rizkyarfians/spff-iot-greenhouse/frontend/src/assets/login-greenhouse.png

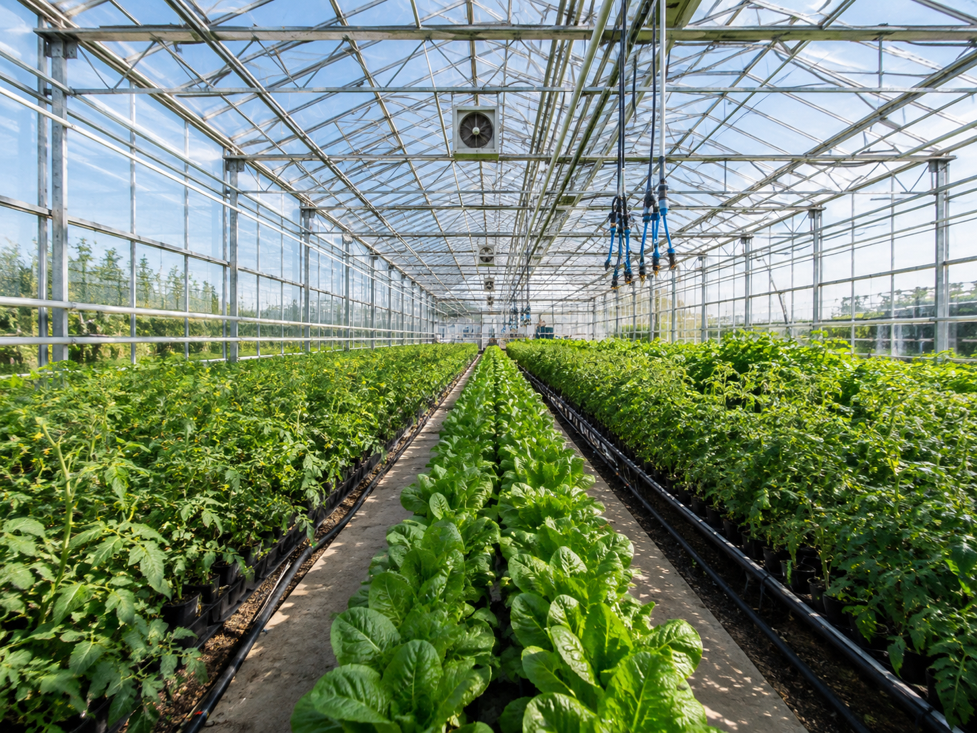
frontend/src/assets/login-greenhouse.png
