rizkyarfians/spff-iot-greenhouse/packages/contracts/README.md

# @spff/contracts

Package bersama untuk model dashboard serta protokol ESP32, edge gateway, MQTT worker, dan cloud API.

Perubahan yang tidak backward-compatible harus menaikkan `schemaVersion` dan mempertahankan handler versi lama selama proses migrasi device.
