rizkyarfians/spff-iot-greenhouse/firmware/SPFF_MASTER_ESP32S3_OTA_1.3.2_SENSOR_HEALTH/README.md

# SPFF 1.4.34 INDEPENDENT AI

Lihat docs/independent-soil-ec-ai.md di repository atau PANDUAN.md pada paket ZIP.
Seluruh file .h harus berada bersama sketch ini. Profil build ada di BUILD_PROFILE.json.
Binary paket adalah aplikasi saja, bukan merged full-flash. Upload melalui Arduino IDE
atau jalur OTA yang sudah mengetahui partisi aktif. Jangan menulis aplikasi ke 0x0.
Belum diuji pada hardware lapangan.
