rizkyarfians/spff-iot-greenhouse/docs/flowchart-datalog-local.png

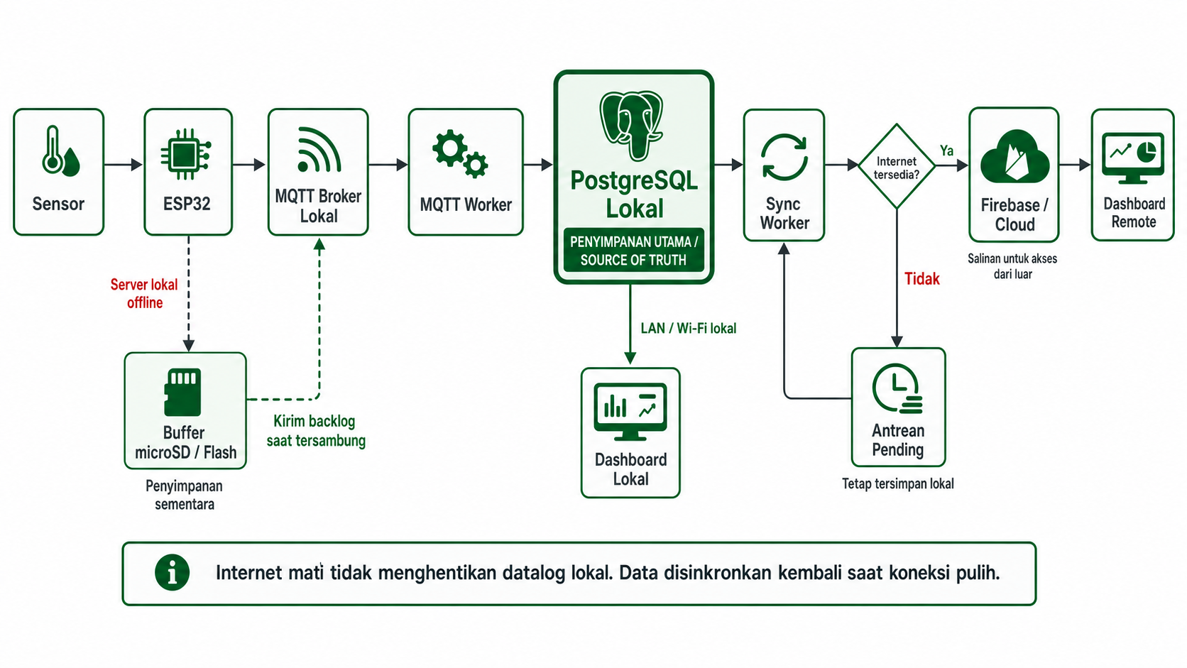
docs/flowchart-datalog-local.png
