rizkyarfians/spff-iot-greenhouse/docs/system-block-diagram-a4.jpg

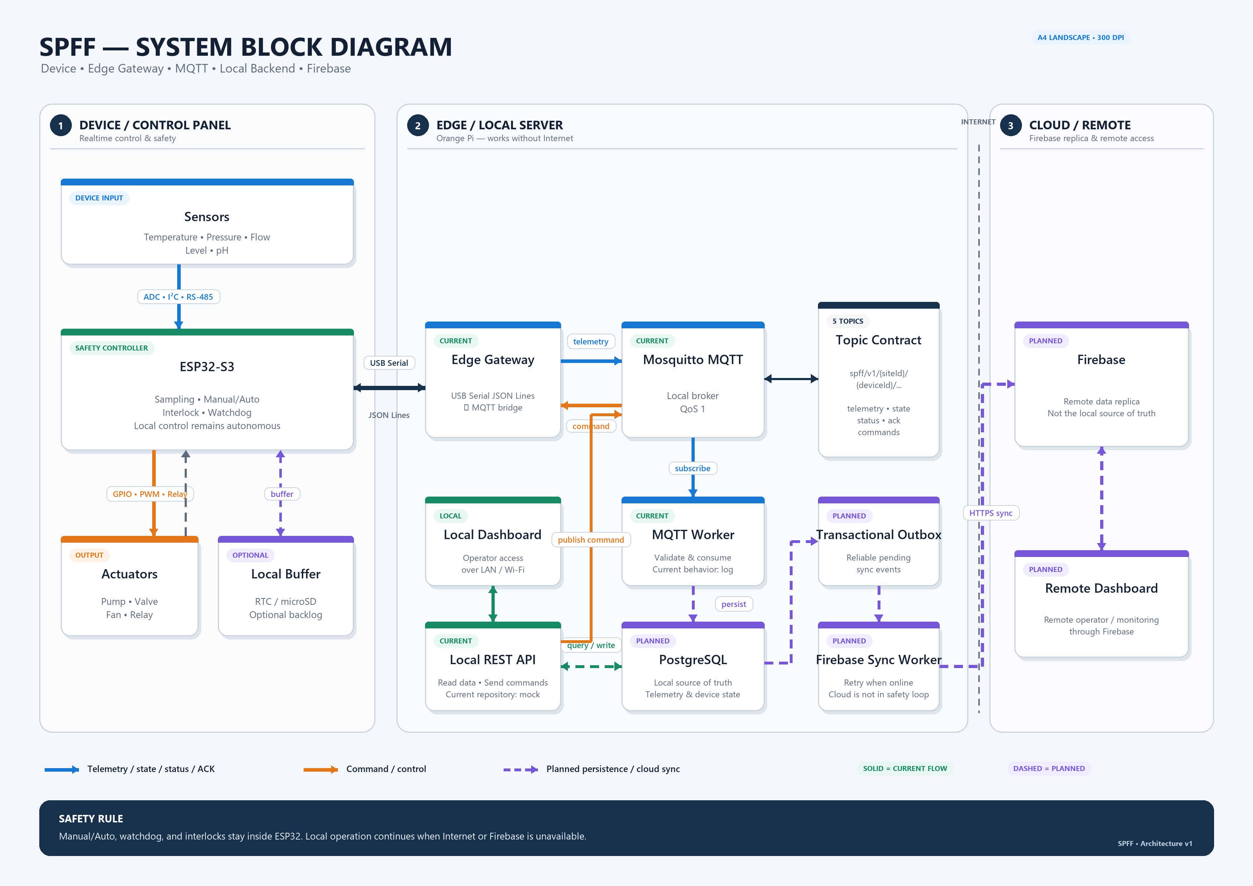
docs/system-block-diagram-a4.jpg
