rizkyarfians/spff-iot-greenhouse/firmware/SPFF_MASTER_1.4.10_SCHEDULE_SENSOR/SPFF_MASTER_1.4.10_SCHEDULE_SENSOR.ino

/*
  =============================================================================
  S2PFS MASTER SPFF FIRMWARE 1.4.7 RS485 PACING + ASYNC NETWORK + MANUAL MONITOR NAV + PZEM GPIO1/2
  Based on S2PFS Master V8.9.1 Edge Contract
  Waveshare ESP32-S3-ETH-8DI-8RO
  =============================================================================

  TUJUAN
  - Firmware master production dengan heartbeat dan Web OTA aman.
  - Menerima command set_pump JSON Lines dari Orange Pi dengan validation,
    expiry, dedup commandId, ACK accepted/completed/rejected, dan relay readback.
  - actuator_state hanya dikirim saat boot, actual state berubah, atau fault.
  - Mengirim device_status JSON Lines setelah init, setiap 30 detik, dan saat
    mode/sensor/system state berubah tanpa bergantung pada telemetry.
  - Telemetry snapshot dikirim tiap 30 detik dari last-valid per parameter (maks 300 detik / 5 menit).
  - Membaca:
      1) Nutrisense EC/pH       ID1 @ 9600, FC03
      2) SHT20 RS485            ID3 @ 9600, FC04
      3) ESP32 Slave PCB        ID5 @ 9600, FC03
      4) Soil 7-in-1 #1         ID1, adaptive sekitar 4800
      5) Soil 7-in-1 #2         ID2, adaptive sekitar 4800
      6) PZEM-004T v3           UART TTL dedicated GPIO1/2 @ 9600, FC04
  - W5500 Ethernet DHCP pada GPIO12..16; WiFi/AP tetap fallback untuk Web OTA.
  - NTP via Ethernet (prioritas) atau WiFi (fallback), lalu menulis RTC PCF85063.
  - LCD 20x4 + 4 tombol.
  - RTC onboard PCF85063/compatible @ I2C 0x51.
  - SHT20 terhubung langsung ke main RS485 A/B.
  - Sensor tetap dipoll terus; snapshot memakai last-good per field dengan batas umur 300 detik / 5 menit.
  - Fungsi THC15A diimplementasikan sebagai TIMER SOFTWARE di LCD.
  - Tidak ada sambungan fisik THC15A ke Master.
  - Full snapshot schedule_sync divalidasi, disimpan atomik ke NVS, dan dibalas
    schedule_sync_ack applied/rejected dengan revision dan storedScheduleCount.
  - automatic_control_sync disimpan ke NVS dan menjalankan hysteresis moisture
    serta closed-loop EC dosing dengan runtime/flow/volume/cooldown interlock.
  - Authority server: Orange Pi mengeksekusi jadwal melalui command set_pump.
  - Authority device: ESP32 mengeksekusi snapshot NVS untuk kedua pompa.
  - Timer mingguan lokal legacy tetap tersimpan tetapi tidak menulis relay.
  - Slave RS485 final memakai MAX485 MANUAL: RE+DE -> GPIO4.

  HARDWARE MASTER
  - RS485 onboard: RX GPIO18, TX GPIO17
  - PZEM TTL dedicated: ESP RX GPIO1 <- PZEM TX, ESP TX GPIO2 -> PZEM RX
  - W5500: INT12, MOSI13, MISO14, SCLK15, CS16
  - I2C: SDA GPIO42, SCL GPIO41
  - LCD: 0x27 atau 0x3F
  - RTC: 0x51
  - TCA9554 relay: 0x20
  - DI1 GPIO4  = CANCEL
  - DI2 GPIO5  = OK
  - DI3 GPIO6  = UP
  - DI4 GPIO7  = DOWN
  - Tombol INPUT_PULLUP, ACTIVE LOW

  SLAVE ID5 REGISTER
  HR0 = jarak tandon air cm x10
  HR1 = jarak tandon pupuk cm x10
  HR2 = flow air L/min x100
  HR3 = flow pupuk L/min x100
  HR4 = total air mL high word
  HR5 = total air mL low word
  HR6 = total pupuk mL high word
  HR7 = total pupuk mL low word

  LIBRARY EKSTERNAL MASTER
  - LiquidCrystal_I2C
  - Ethernet (Arduino Ethernet 2.x, W5500)
  Built-in:
  - Wire
  - Preferences
  - WiFi / WiFiUDP / WebServer / Update
  - SPI

  Serial protocol: 115200 JSON Lines
  =============================================================================
*/

#include <Arduino.h>
#include <Wire.h>
#include <LiquidCrystal_I2C.h>
#include <Preferences.h>
#include <WiFi.h>
#include <WiFiUdp.h>
#include <WebServer.h>
#include <Update.h>
#include <SPI.h>
#include <Ethernet.h>
#include <EthernetUdp.h>
#include <Dns.h>
#include <time.h>
#include <esp_system.h>
#include <math.h>
#include <stddef.h>
#include <string.h>

// Forward declarations untuk Arduino auto-prototype.
struct WeeklySchedule;
enum TimerMode : uint8_t;
enum ButtonId : uint8_t;
struct ButtonState;
struct PzemData;
struct SoilData;
struct CachedFloatValue;
struct CachedUIntValue;

// =============================================================================
// PRODUCTION SERIAL POLICY
// =============================================================================
// USB Serial dipakai eksklusif untuk SPFF JSON Lines. Human-readable debug,
// plotter, dan compact output dihapus dari build produksi agar tidak mencemari
// protokol Edge Gateway dan tidak menarik formatter/format string yang besar.

// ESP32 Arduino Core 2.0.x compatibility:
// - user-defined button types are declared before Arduino-generated prototypes
// - String(float, decimals) uses an explicit unsigned-int cast

// =============================================================================
// CONFIG
// =============================================================================
static constexpr uint8_t RS485_RX_PIN = 18;
static constexpr uint8_t RS485_TX_PIN = 17;

// PZEM-004T v3 dedicated TTL UART on GPIO44/GPIO43.
// USB CDC remains on native USB Serial, so UART pins 43/44 stay dedicated to PZEM.
// User has stabilized the interface voltage; keep the RX level within ESP32-S3 limits.
static constexpr uint8_t PZEM_RX_PIN = 44;  // ESP RX <- PZEM TX
static constexpr uint8_t PZEM_TX_PIN = 43;  // ESP TX -> PZEM RX
static constexpr uint32_t PZEM_BAUD = 9600UL;
static constexpr uint8_t PZEM_GENERAL_ADDRESS = 0xF8;
static constexpr uint8_t PZEM_DEFAULT_ADDRESS = 0x01;
static constexpr uint32_t PZEM_READ_INTERVAL_MS = 5000UL;
static constexpr uint32_t PZEM_HEALTH_MAX_AGE_MS = 60000UL;
static constexpr uint32_t PZEM_RESPONSE_TIMEOUT_MS = 350UL;

// Waveshare ESP32-S3-(POE)-ETH-8DI-8RO onboard W5500.
static constexpr uint8_t ETH_INT_PIN  = 12;
static constexpr uint8_t ETH_MOSI_PIN = 13;
static constexpr uint8_t ETH_MISO_PIN = 14;
static constexpr uint8_t ETH_SCLK_PIN = 15;
static constexpr uint8_t ETH_CS_PIN   = 16;
static constexpr uint32_t ETHERNET_MAINTAIN_INTERVAL_MS = 1000UL;

// NTP only disciplines the local RTC. System remains local-first when network is absent.
static constexpr char NTP_SERVER_PRIMARY[] = "pool.ntp.org";
static constexpr char NTP_SERVER_FALLBACK[] = "time.google.com";
static constexpr uint16_t NTP_LOCAL_PORT = 2390;
static constexpr uint32_t NTP_SYNC_INTERVAL_MS = 6UL * 60UL * 60UL * 1000UL;
static constexpr uint32_t NTP_RETRY_INTERVAL_MS = 5UL * 60UL * 1000UL;
static constexpr uint32_t NTP_INITIAL_DELAY_MS = 15000UL;
static constexpr uint32_t NTP_RESPONSE_TIMEOUT_MS = 1800UL;

// V1.4.6: Ethernet DHCP/DNS/NTP dipindahkan ke FreeRTOS background task.
// Operasi network yang bisa blocking tidak lagi berjalan di main control/UI loop.
// Bila internet/DHCP/NTP gagal, local control + sensor + USB gateway tetap berjalan.
static constexpr bool SPFF_ENABLE_ETHERNET_RUNTIME = true;
static constexpr bool SPFF_ENABLE_NTP_RUNTIME = true;
static constexpr uint32_t ETHERNET_RETRY_INTERVAL_MS = 60000UL;
static constexpr uint32_t NETWORK_TASK_INTERVAL_MS = 100UL;
static constexpr uint32_t NETWORK_TASK_STACK_BYTES = 7168UL;

static constexpr uint8_t I2C_SDA_PIN = 42;
static constexpr uint8_t I2C_SCL_PIN = 41;

static constexpr uint8_t BTN_CANCEL_PIN = 4;
static constexpr uint8_t BTN_OK_PIN     = 5;
static constexpr uint8_t BTN_UP_PIN     = 6;
static constexpr uint8_t BTN_DOWN_PIN   = 7;

// Waveshare ESP32-S3-ETH-8DI-8RO onboard buzzer.
// Board ini membutuhkan PWM/tone pada GPIO46.
// API di bawah kompatibel dengan ESP32 Arduino Core lama
// (ledcSetup + ledcAttachPin), sesuai core yang sedang dipakai.
static constexpr uint8_t BUZZER_PIN = 46;
static constexpr uint8_t BUZZER_CHANNEL = 0;
static constexpr uint32_t BUZZER_FREQ_HZ = 2700UL;
static constexpr uint8_t BUZZER_RESOLUTION_BITS = 8;

// Bunyi tombol pendek dan NON-BLOCKING agar UI tetap responsif.
static constexpr uint32_t BUTTON_BEEP_MS = 35UL;


static constexpr uint8_t NUTRI_ID = 1;
static constexpr uint8_t SHT20_ID = 3;
static constexpr uint8_t SOIL1_ID = 1;
static constexpr uint8_t SOIL2_ID = 2;
static constexpr uint8_t SLAVE_ID = 5;

static constexpr uint32_t BAUD_9600 = 9600UL;
static constexpr uint8_t SHT20_READ_ATTEMPTS = 3;
static constexpr uint32_t SHT20_RESPONSE_TIMEOUT_MS = 900UL;
static constexpr uint32_t SHT20_RETRY_GAP_MS = 160UL;
static constexpr uint8_t SHT20_FORCE_REOPEN_AFTER_ATTEMPT = 1;
static constexpr uint8_t SHT20_SPLIT_READ_ATTEMPTS = 2;
static constexpr uint32_t SHT20_PRE_REQUEST_QUIET_MS = 160UL;
static constexpr uint32_t SOIL_DEFAULT_BAUD = 4800UL;

// V8.4.1 SOIL FIX:
// Satu sensor Modbus mempunyai SATU baud, bukan baud berbeda per register.
// Kedua soil 7-in-1 dipoll sebagai satu blok FC03 R0..R6 @4800.
static constexpr uint32_t SOIL_FIXED_BAUD = 4850UL;
static constexpr uint32_t SOIL_SINGLE_TIMEOUT_MS = 260UL;

// FAST + ACCURATE rolling soil:
// tidak memaksa 7 register fresh pada cycle yang sama.
// Tiga register per sensor dicoba setiap cycle, hasil CRC-valid disimpan.
// Freshness internal Soil tetap 60 detik untuk health/priority polling.
// Telemetry snapshot boleh membawa last-valid field sampai 300 detik / 5 menit.
static constexpr uint8_t SOIL_REGS_PER_CYCLE = 3;
static constexpr uint8_t SOIL_ACQUIRE_RETRY = 5;
static constexpr uint8_t SOIL_MAINTENANCE_RETRY = 2;
static constexpr uint32_t SOIL_FIELD_MAX_AGE_MS = 60000UL;

static constexpr uint32_t SENSOR_CYCLE_INTERVAL_MS = 10000UL;
static constexpr uint32_t SHARED_RS485_POST_DEVICE_GAP_MS = 250UL;
static constexpr uint32_t LCD_REFRESH_MS = 250UL;


// Kalau satu polling Slave gagal tetapi data valid terakhir masih <=60 detik,
// data tetap boleh dipakai sebagai CACHE. Ini tidak memalsukan data baru;
// hanya menjaga tampilan/monitoring tidak jatuh ke STALE karena satu timeout.
static constexpr uint32_t SLAVE_CACHE_MAX_AGE_MS = 60000UL;

// V8.4.8:
// Sensor lambat tidak dinilai dari satu request saja.
// Fresh read tetap diutamakan, tetapi last-good singkat tetap dianggap sehat.
static constexpr uint32_t NUTRI_CACHE_MAX_AGE_MS = 60000UL;

// =============================================================================
// SOFTWARE CALIBRATION HOOKS - NUTRISENSE
// =============================================================================
// Default = identity, jadi TIDAK mengubah pembacaan sampai hasil kalibrasi
// terhadap larutan/alat referensi sudah tersedia.
// corrected = raw * GAIN + OFFSET
static constexpr float NUTRI_PH_GAIN = 1.0f;
static constexpr float NUTRI_PH_OFFSET = 0.0f;
static constexpr float NUTRI_EC_GAIN = 1.0f;
static constexpr float NUTRI_EC_OFFSET = 0.0f;
static constexpr float NUTRI_TEMP_GAIN = 1.0f;
static constexpr float NUTRI_TEMP_OFFSET = 0.0f;

// Status Soil ditentukan dari komunikasi sensor secara keseluruhan,
// bukan apakah semua 7 register berhasil refresh bersamaan.
// Jika tidak ada register valid selama 60 detik, sensor dianggap tidak current.
static constexpr uint32_t SOIL_SENSOR_MAX_SILENCE_MS = 60000UL;

static constexpr uint8_t TCA9554_ADDR = 0x20;
static constexpr uint8_t TCA_OUTPUT_REG = 0x01;
static constexpr uint8_t TCA_POLARITY_REG = 0x02;
static constexpr uint8_t TCA_CONFIG_REG = 0x03;

// FINAL ACTUATOR MAPPING - SESUAI WIRING FISIK PANEL
// CH1 = Pompa Nutrisi / Pupuk
// CH2 = Kosong
// CH3 = Pompa Penyiraman / Air
// CH4 = Kosong
// CH5..CH8 = Cadangan
//
// SHT20 terhubung LANGSUNG ke main RS485 A/B.
// Tidak ada relay isolasi SHT pada versi final ini.
static constexpr uint8_t RELAY_NUTRIENT = 1;    // CH1
static constexpr uint8_t RELAY_IRRIGATION = 3;  // CH3

static constexpr uint8_t PUMP_FERTILIZER_RELAY = RELAY_NUTRIENT;
static constexpr uint8_t PUMP_WATER_RELAY = RELAY_IRRIGATION;

static constexpr uint8_t RTC_ADDR = 0x51;

// PCF85063 register map:
// 0x00 Control_1
// 0x01 Control_2
// 0x02 Offset
// 0x03 RAM byte
// 0x04 Seconds
// 0x05 Minutes
// 0x06 Hours
// 0x07 Days
// 0x08 Weekdays
// 0x09 Months
// 0x0A Years
static constexpr uint8_t RTC_SECONDS_REG = 0x04;

static constexpr uint8_t SOIL_REG_COUNT = 7;

// =============================================================================
// GLOBAL
// =============================================================================
HardwareSerial RS485(1);
HardwareSerial PZEMSerial(2);
Preferences prefs;

EthernetUDP ntpEthernetUdp;
WiFiUDP ntpWifiUdp;

volatile bool ethernetInitialized = false;
volatile bool ethernetHasAddress = false;
uint32_t lastEthernetMaintainMs = 0;
uint32_t lastEthernetDhcpAttemptMs = 0;
uint32_t lastNtpAttemptMs = 0;
uint32_t lastNtpSuccessMs = 0;
volatile bool ntpEverSynced = false;

TaskHandle_t spffNetworkTaskHandle = nullptr;
portMUX_TYPE spffNetworkStateMux = portMUX_INITIALIZER_UNLOCKED;
volatile bool pendingNtpEpochReady = false;
uint32_t pendingNtpUtcEpoch = 0;

// Forward declaration: nilai SSID dipakai oleh LCD sebelum implementasi WiFi/OTA.
extern String fieldWifiSsid;

uint32_t activeBaud = 0;
uint32_t lastCycleStartMs = 0;


// =============================================================================
// SPFF EDGE GATEWAY - USB SERIAL JSON LINES
// =============================================================================
// Sesuai panduan integrasi:
// ESP32-S3 <-> USB Serial JSON Lines <-> Orange Pi Edge Gateway <-> MQTT
//
// Orange Pi:
//   Serial baud : 115200
//
// ESP32 TIDAK connect langsung ke MQTT.
static constexpr char SPFF_SITE_ID[] = "greenhouse-01";
static constexpr char SPFF_DEVICE_ID[] = "esp32-s3-01";
static constexpr char SPFF_FIRMWARE_VERSION[] = "1.4.10";

// Timer LCD/NVS legacy tidak boleh menjadi writer relay bersamaan dengan
// backend atau snapshot device. Data legacy tetap dipertahankan untuk rollback.
static constexpr bool SPFF_DISABLE_LEGACY_LOCAL_TIMER = true;

// Satu frame JSON termasuk terminator LF tidak boleh melebihi 16 KiB.
static constexpr size_t SPFF_SERIAL_FRAME_MAX = 16384;

// Arduino ESP32 Core 2.0.17 memakai RX queue USB CDC default 256 byte.
// Command set_pump sekitar 309 byte dan schedule_sync bisa mendekati 16 KiB,
// jadi queue harus dibesarkan sebelum Serial.begin() agar frame tidak terpotong.
static constexpr size_t SPFF_SERIAL_RX_QUEUE_BYTES = SPFF_SERIAL_FRAME_MAX;

// Heartbeat device hidup terpisah dari jadwal polling/pengiriman telemetry.
static constexpr uint32_t SPFF_STATUS_HEARTBEAT_INTERVAL_MS = 30000UL;
static constexpr uint32_t SPFF_STATUS_TIME_RETRY_INTERVAL_MS = 1000UL;
static constexpr uint32_t SPFF_SENSOR_VALID_MAX_SILENCE_MS = 300000UL;

// Telemetry snapshot dipublish setiap 30 detik. Sensor tetap dipoll terus
// mengikuti scheduler existing; publish tidak menunggu pembacaan dimulai.
static constexpr uint32_t SPFF_TELEMETRY_PUBLISH_INTERVAL_MS = 30000UL;

// Last-valid per parameter boleh dibawa ke snapshot berikutnya selama maksimal
// 300 detik / 5 menit. Setelah lewat batas ini field di-omit, bukan diisi nilai dummy.
// Cache ini hanya untuk TELEMETRY SNAPSHOT/dashboard. Safety, interlock, dan
// automatic control tetap memakai state pembacaan sensor current yang existing.
static constexpr uint32_t SPFF_TELEMETRY_SNAPSHOT_MAX_AGE_MS = 300000UL;
static constexpr uint8_t SPFF_SUPPORTED_TELEMETRY_FIELD_COUNT = 31;

// RTC Master saat ini dianggap waktu lokal WIB / UTC+7.
// recordedAt untuk gateway harus UTC ISO-8601 dengan akhiran Z.
static constexpr int16_t SPFF_LOCAL_UTC_OFFSET_MINUTES = 7 * 60;

// schedule_sync adalah full snapshot dan dapat mendekati batas Serial 16 KiB.
// Reserve awal tetap kecil; String tumbuh hanya ketika snapshot besar diterima.
static constexpr size_t SPFF_RX_LINE_MAX = SPFF_SERIAL_FRAME_MAX - 1U;
static constexpr size_t SPFF_RX_INITIAL_RESERVE = 2048U;
static constexpr uint8_t SPFF_JSON_MAX_DEPTH = 8;
static constexpr size_t SPFF_COMMAND_ID_MAX = 96;
static constexpr size_t SPFF_COMMAND_TARGET_MAX = 20;
static constexpr size_t SPFF_COMMAND_REASON_MAX = 32;
static constexpr uint8_t SPFF_COMMAND_HISTORY_SIZE = 16;
static constexpr uint32_t SPFF_ACTUATOR_STATE_POLL_INTERVAL_MS = 1000UL;

enum SpffSystemState : uint8_t {
  SPFF_SYSTEM_WAITING_TELEMETRY = 0,
  SPFF_SYSTEM_MONITORING = 1,
  SPFF_SYSTEM_DEGRADED = 2,
  SPFF_SYSTEM_SENSOR_FAULT = 3
};

String spffRxLine;
bool spffRxDroppingOversize = false;

char spffBootId[17] = {0};
uint32_t spffStatusCounter = 0;
uint32_t spffLastStatusSentMs = 0;
uint32_t spffLastStatusAttemptMs = 0;
uint32_t spffLastValidSensorMs = 0;
uint8_t spffObservedTimerMode = 0;
bool spffStatusEverSent = false;
bool spffStatusDirty = true;
bool spffStatusInitialized = false;
bool spffStatusModeInitialized = false;
bool spffLastStatusAttemptFailed = false;
bool spffSensorValid = false;
bool spffTelemetryEverValid = false;
SpffSystemState spffSystemState = SPFF_SYSTEM_WAITING_TELEMETRY;


struct SpffActuatorStateTracker {
  bool initialized = false;
  bool stateKnown = false;
  bool isActive = false;
};

struct SpffCommandHistoryEntry {
  bool used = false;
  char commandId[SPFF_COMMAND_ID_MAX + 1] = {0};
  char targetId[SPFF_COMMAND_TARGET_MAX + 1] = {0};
  char acknowledgedAt[25] = {0};
  char status[10] = {0};
  bool actualStateKnown = false;
  bool actualActive = false;
  char reason[SPFF_COMMAND_REASON_MAX + 1] = {0};
};

SpffActuatorStateTracker spffWaterStateTracker;
SpffActuatorStateTracker spffFertStateTracker;
SpffCommandHistoryEntry spffCommandHistory[SPFF_COMMAND_HISTORY_SIZE];
uint8_t spffCommandHistoryCursor = 0;
uint32_t spffActuatorStateCounter = 0;
uint32_t spffLastActuatorStatePollMs = 0;
String spffCurrentCommandIssuedAt;

static constexpr uint8_t SPFF_SYNCED_SCHEDULE_MAX = 64;
static constexpr uint32_t SPFF_SCHEDULE_STORE_MAGIC = 0x53504646UL;
static constexpr uint16_t SPFF_SCHEDULE_STORE_FORMAT = 1U;
static constexpr char SPFF_SCHEDULE_NVS_KEY[] = "srv_sched";

enum SpffScheduleAuthority : uint8_t {
  SPFF_SCHEDULE_AUTHORITY_SERVER = 0,
  SPFF_SCHEDULE_AUTHORITY_DEVICE = 1
};

enum SpffScheduleTarget : uint8_t {
  SPFF_SCHEDULE_TARGET_WATER = 1,
  SPFF_SCHEDULE_TARGET_FERT = 2
};

enum SpffScheduleRepeat : uint8_t {
  SPFF_SCHEDULE_REPEAT_DAILY = 1,
  SPFF_SCHEDULE_REPEAT_WEEKDAYS = 2,
  SPFF_SCHEDULE_REPEAT_WEEKENDS = 3,
  SPFF_SCHEDULE_REPEAT_ONCE = 4
};

struct SpffSyncedSchedule {
  uint32_t scheduleIdHash = 0;
  uint32_t onSecond = 0;
  uint32_t offSecond = 0;
  uint16_t runYear = 0;
  uint8_t runMonth = 0;
  uint8_t runDay = 0;
  uint8_t target = 0;
  uint8_t repeatRule = 0;
  uint8_t enabled = 0;
  uint8_t reserved = 0;
};

struct SpffSyncedScheduleStore {
  uint32_t magic = 0;
  uint16_t formatVersion = 0;
  uint8_t authority = SPFF_SCHEDULE_AUTHORITY_SERVER;
  uint8_t count = 0;
  uint32_t revision = 0;
  SpffSyncedSchedule schedules[SPFF_SYNCED_SCHEDULE_MAX];
  uint32_t checksum = 0;
};

SpffSyncedScheduleStore spffSyncedScheduleStore;
bool spffSyncedScheduleLoaded = false;

static constexpr uint32_t SPFF_AUTO_STORE_MAGIC = 0x4155544FUL;
static constexpr uint16_t SPFF_AUTO_STORE_FORMAT = 1U;
static constexpr char SPFF_AUTO_NVS_KEY[] = "auto_ctrl";
static constexpr char SPFF_AUTO_DAILY_NVS_KEY[] = "auto_daily";
static constexpr uint32_t SPFF_AUTO_DAILY_STORE_MAGIC = 0x4441494CUL;
static constexpr uint32_t SPFF_AUTO_EVAL_INTERVAL_MS = 500UL;
static constexpr uint32_t SPFF_AUTO_FLOW_GRACE_MS = 5000UL;

enum SpffOperatingMode : uint8_t {
  SPFF_MODE_MANUAL = 0,
  SPFF_MODE_AUTOMATIC = 1
};

enum SpffAutoFertState : uint8_t {
  SPFF_FERT_IDLE = 0,
  SPFF_FERT_DOSING = 1,
  SPFF_FERT_MIXING = 2
};

struct SpffWaterAutomaticConfig {
  uint8_t enabled = 0;
  uint8_t sensor = 1;
  uint8_t triggerSampleCount = 3;
  uint8_t reserved = 0;
  float moistureLowPercent = 0;
  float moistureTargetPercent = 0;
  float minFlowLpm = 0;
  uint32_t maxRuntimeSeconds = 0;
  uint32_t cooldownSeconds = 0;
  uint32_t sensorStaleSeconds = 120;
};

struct SpffFertilizerAutomaticConfig {
  uint8_t enabled = 0;
  uint8_t triggerSampleCount = 3;
  uint16_t reserved = 0;
  float ecLowUsCm = 0;
  float ecTargetUsCm = 0;
  float ecHighUsCm = 0;
  float maxDoseVolumeL = 0;
  float maxDailyVolumeL = 0;
  float minFlowLpm = 0;
  uint32_t dosePulseSeconds = 0;
  uint32_t mixingDelaySeconds = 0;
  uint32_t cooldownSeconds = 0;
  uint32_t sensorStaleSeconds = 120;
};

struct SpffAutomaticControlStore {
  uint32_t magic = 0;
  uint16_t formatVersion = 0;
  uint8_t desiredMode = SPFF_MODE_MANUAL;
  uint8_t reserved = 0;
  uint32_t revision = 0;
  SpffWaterAutomaticConfig water;
  SpffFertilizerAutomaticConfig fertilizer;
  uint32_t checksum = 0;
};

struct SpffAutomaticDailyStore {
  uint32_t magic = SPFF_AUTO_DAILY_STORE_MAGIC;
  uint16_t dateKey = 0;
  uint16_t reserved = 0;
  uint32_t fertilizerStartTotalMl = 0;
  uint32_t checksum = 0;
};

SpffAutomaticControlStore spffAutomaticControl;
bool spffAutomaticControlLoaded = false;
bool spffAutomaticPaused = false; // Dashboard OFF pauses auto until settings are explicitly saved again.
uint32_t spffLastAutoEvaluationMs = 0;
bool spffShutdownPending = false;
bool spffShutdownFaultLatched = false;

static void spffLoadShutdownFaultLatch() {
  const PreferenceType type = prefs.getType("pump_fault");

  if (type == PT_U8) {
    spffShutdownFaultLatched = prefs.getBool("pump_fault", true);
  } else if (type == PT_INVALID && !prefs.isKey("pump_fault")) {
    // Key belum tersedia: kondisi instalasi pertama.
    spffShutdownFaultLatched = false;
  } else {
    // Tipe data tidak sesuai: blokir ON.
    spffShutdownFaultLatched = true;
  }
}

static bool spffSaveShutdownFaultLatch() {
  return prefs.putBool(
    "pump_fault",
    spffShutdownFaultLatched
  ) == 1U;
}
uint32_t spffLastShutdownRetryMs = 0;
static constexpr uint32_t SPFF_SHUTDOWN_RETRY_INTERVAL_MS = 2000UL;
uint32_t spffWaterLastSampleMs = 0;
uint8_t spffWaterLowSampleCount = 0;
bool spffWaterAutoActive = false;
uint32_t spffWaterStartedMs = 0;
uint32_t spffWaterCooldownStartedMs = 0;
uint32_t spffFertLastSampleMs = 0;
uint8_t spffFertLowSampleCount = 0;
SpffAutoFertState spffFertState = SPFF_FERT_IDLE;
bool spffFertCycleLatched = false;
uint32_t spffFertStateStartedMs = 0;
uint32_t spffFertCooldownStartedMs = 0;
uint32_t spffFertPulseStartTotalMl = 0;
uint32_t spffFertCycleStartTotalMl = 0;
uint32_t spffFertDailyStartTotalMl = 0;
uint16_t spffFertDailyDateKey = 0;


LiquidCrystal_I2C lcd27(0x27, 20, 4);
LiquidCrystal_I2C lcd3F(0x3F, 20, 4);
LiquidCrystal_I2C *lcd = nullptr;
bool lcdReady = false;
// Redraw LCD dijadwalkan, bukan dilakukan langsung dari callback tombol.
// Ini mencegah I2C LCD masuk di tengah transaksi sensor/network dan menjaga UI responsif.
bool lcdDirty = true;

bool relayReady = false;
uint8_t relayState = 0;

bool rtcReady = false;

// =============================================================================
// DATA TYPES
// =============================================================================
struct RTCDateTime {
  uint8_t second = 0;
  uint8_t minute = 0;
  uint8_t hour = 0;
  uint8_t day = 1;
  uint8_t weekday = 0;
  uint8_t month = 1;
  uint8_t year = 0; // 00..99 = 2000..2099
  bool valid = false;
  bool oscillatorStopped = false;
};

RTCDateTime rtcNow;

struct NutriData {
  float ph = NAN;
  float ec = NAN;
  float temp = NAN;
  bool hasValue = false;
  bool fresh = false;
  uint32_t lastGoodMs = 0;
};

struct SHTData {
  float temp = NAN;
  float rh = NAN;
  bool hasValue = false;
  bool fresh = false;
  uint32_t lastGoodMs = 0;
};

struct PzemData {
  float voltageV = NAN;
  float currentA = NAN;
  float powerW = NAN;
  float energyKwh = NAN;
  float frequencyHz = NAN;
  float powerFactor = NAN;
  bool hasValue = false;
  bool fresh = false;
  uint32_t lastGoodMs = 0;
  uint32_t lastAttemptMs = 0;
  uint8_t respondingAddress = 0;
};

struct SoilData {
  uint16_t raw[SOIL_REG_COUNT] = {0,0,0,0,0,0,0};
  bool has[SOIL_REG_COUNT] = {false,false,false,false,false,false,false};
  bool freshField[SOIL_REG_COUNT] = {false,false,false,false,false,false,false};
  uint32_t regBaud[SOIL_REG_COUNT] = {
    SOIL_DEFAULT_BAUD, SOIL_DEFAULT_BAUD, SOIL_DEFAULT_BAUD,
    SOIL_DEFAULT_BAUD, SOIL_DEFAULT_BAUD, SOIL_DEFAULT_BAUD,
    SOIL_DEFAULT_BAUD
  };
  uint32_t fallbackBaud = SOIL_DEFAULT_BAUD;
  bool complete = false;
  bool fresh = false;
  uint32_t lastGoodMs = 0;
};

struct SlaveData {
  float waterDistanceCm = NAN;
  float fertDistanceCm = NAN;
  float waterFlowLpm = NAN;
  float fertFlowLpm = NAN;
  uint32_t waterTotalMl = 0;
  uint32_t fertTotalMl = 0;
  bool waterDistanceValid = false;
  bool fertDistanceValid = false;
  bool totalsAvailable = false;
  bool hasValue = false;
  bool fresh = false;
  uint32_t lastGoodMs = 0;
};

// =============================================================================
// TELEMETRY SNAPSHOT CACHE
// =============================================================================
// Cache ini menyimpan last-valid PER PARAMETER beserta waktu pembacaan aslinya.
// Timestamp cache TIDAK diperbarui jika sensor gagal dibaca, sehingga nilai lama
// tidak pernah dibuat terlihat lebih fresh dari kondisi sebenarnya.
struct CachedFloatValue {
  float value = NAN;
  uint32_t updatedMs = 0;
  bool hasValue = false;
};

struct CachedUIntValue {
  uint32_t value = 0;
  uint32_t updatedMs = 0;
  bool hasValue = false;
};

struct TelemetrySnapshotCache {
  CachedFloatValue liquidPh;
  CachedFloatValue liquidEcUsCm;
  CachedFloatValue liquidTemp;
  CachedFloatValue airTemp;
  CachedFloatValue airHumidity;

  CachedFloatValue acVoltageV;
  CachedFloatValue acCurrentA;
  CachedFloatValue acPowerW;
  CachedFloatValue acEnergyKwh;
  CachedFloatValue acFrequencyHz;
  CachedFloatValue acPowerFactor;

  CachedFloatValue soil1Moisture;
  CachedFloatValue soil1Temp;
  CachedUIntValue soil1EcUsCm;
  CachedFloatValue soil1Ph;
  CachedUIntValue soil1N;
  CachedUIntValue soil1P;
  CachedUIntValue soil1K;

  CachedFloatValue soil2Moisture;
  CachedFloatValue soil2Temp;
  CachedUIntValue soil2EcUsCm;
  CachedFloatValue soil2Ph;
  CachedUIntValue soil2N;
  CachedUIntValue soil2P;
  CachedUIntValue soil2K;

  CachedFloatValue tankWaterDistanceCm;
  CachedFloatValue tankFertDistanceCm;
  CachedFloatValue flowWaterLpm;
  CachedFloatValue flowFertLpm;
  CachedFloatValue flowWaterTotalL;
  CachedFloatValue flowFertTotalL;
};


// =============================================================================
// WEEKLY TIMER SOFTWARE - PENGGANTI THC15A
// =============================================================================
// Fitur:
// - 16 program mingguan.
// - Jam aktif dan jam nonaktif masing-masing sampai presisi menit.
// - Mode OTOMATIS / PAKSA AKTIF / PAKSA NONAKTIF.
// - Atur jam & tanggal RTC dari LCD.
// - Hapus satu program / hapus semua program.
// - Semua pengaturan timer disimpan ke NVS.
//
// CATATAN KESELAMATAN:
// Output timer MENGENDALIKAN relay penyiraman CH3 (PUMP_WATER_RELAY).
// CH1 pompa nutrisi TIDAK pernah ikut timer penyiraman.
// Saat timer tidak aktif, CH3 dipaksa OFF. Saat timer aktif, CH3 dipaksa ON.

struct WeeklySchedule {
  bool enabled = false;
  uint8_t daysMask = 0x3F;   // Senin-Sabtu
  uint16_t startMinute = 360; // 06:00
  uint16_t endMinute = 390;   // 06:30
};

static constexpr uint8_t WEEKLY_SCHEDULE_COUNT = 16;

// Hari memakai bit:
// bit0 Senin, bit1 Selasa, bit2 Rabu, bit3 Kamis,
// bit4 Jumat, bit5 Sabtu, bit6 Minggu.
struct DayPreset {
  const char *name;
  uint8_t mask;
};

const DayPreset DAY_PRESETS[] = {
  {"Setiap Hari", 0x7F},
  {"Senin-Jumat", 0x1F},
  {"Senin-Sabtu", 0x3F},
  {"Senin", 0x01},
  {"Selasa", 0x02},
  {"Rabu", 0x04},
  {"Kamis", 0x08},
  {"Jumat", 0x10},
  {"Sabtu", 0x20},
  {"Minggu", 0x40}
};

static constexpr uint8_t DAY_PRESET_COUNT =
  sizeof(DAY_PRESETS) / sizeof(DAY_PRESETS[0]);

enum TimerMode : uint8_t {
  TIMER_MODE_AUTO = 0,
  TIMER_MODE_FORCE_ON = 1,
  TIMER_MODE_FORCE_OFF = 2
};

WeeklySchedule weeklySchedules[WEEKLY_SCHEDULE_COUNT];
WeeklySchedule editSchedule;

TimerMode timerMode = TIMER_MODE_AUTO;
TimerMode editTimerMode = TIMER_MODE_AUTO;

uint8_t scheduleMenuIndex = 0;
uint8_t scheduleEditIndex = 0;
uint8_t scheduleEditField = 0;
bool scheduleValueEditing = false;

RTCDateTime editRtc;
uint8_t rtcEditField = 0;
bool rtcValueEditing = false;

uint8_t clearProgramIndex = 0;
bool clearProgramConfirm = false;
bool clearAllConfirm = false;


// IMPORTANT:
// Button types are intentionally declared before the first function.
// Arduino IDE auto-generates function prototypes; keeping these types here
// prevents "ButtonState does not name a type" on ESP32 Arduino Core 2.0.x.
enum ButtonId : uint8_t {
  BUTTON_CANCEL,
  BUTTON_OK,
  BUTTON_UP,
  BUTTON_DOWN
};

struct ButtonState {
  uint8_t pin;
  bool stablePressed;
  bool lastRawPressed;
  uint32_t rawChangedMs;

  // Untuk fungsi tahan tombol (auto-repeat).
  uint32_t pressedSinceMs;
  uint32_t lastRepeatMs;

  explicit ButtonState(uint8_t buttonPin)
    : pin(buttonPin),
      stablePressed(false),
      lastRawPressed(false),
      rawChangedMs(0),
      pressedSinceMs(0),
      lastRepeatMs(0) {
  }
};

NutriData nutri;
SHTData sht;
PzemData pzem;
SoilData soil1;
SoilData soil2;
SlaveData slaveData;
bool slaveCycleOk = false;
bool nutriCycleOk = false;
bool shtCycleOk = false;

TelemetrySnapshotCache telemetrySnapshot;
uint32_t spffLastTelemetrySentMs = 0;

uint32_t soil1RegLastGoodMs[SOIL_REG_COUNT] = {0};
uint32_t soil2RegLastGoodMs[SOIL_REG_COUNT] = {0};

uint8_t soil1AcquireCursor = 0;
uint8_t soil2AcquireCursor = 0;

// =============================================================================
// FORWARD DECLARATIONS
// =============================================================================
// Explicit declarations ini penting untuk Arduino ESP32 Core 2.0.17.
// Tanpa ini, Arduino preprocessor kadang membuat prototype sebelum struct
// RTCDateTime / SoilData / WeeklySchedule / ButtonState dideklarasikan.

void appSetup();
void appLoop();

void initEthernet();
void serviceEthernet();
bool ethernetUsable();
void serviceNetworkTime();
bool syncRtcFromNtp();
void startSpffNetworkTask();
void spffNetworkTask(void *parameter);
void clearPzemSerial();
bool readPzem();
void servicePzem();
bool pzemHealthValid();
uint16_t modbusCRC(const uint8_t *data, size_t len);

void serviceSpffGatewaySerial();
void initializeSpffDeviceStatus();
String buildDeviceStatusPayload();
bool sendDeviceStatus();
bool shouldSendStatusHeartbeat();
void serviceDeviceStatus();
void updateSystemState(bool anySensorValid, bool allSensorsValid);
void captureTelemetrySnapshot();
bool telemetrySnapshotHasAnyValidData();
uint8_t telemetrySnapshotValidFieldCount();
uint8_t telemetrySnapshotHealthyFieldCount();
void spffAppendTelemetrySensorHealth(String &json);
bool shouldPublishTelemetrySnapshot();
void serviceTelemetrySnapshot();
void sendTelemetryIfValid();
const char* spffModeText();
const char* spffSystemStateText();
bool spffWriteJsonLine(const String &json);
bool sendSpffTelemetry();
bool sendSpffActuatorStateEvent(
  const char *targetId,
  bool stateKnown,
  bool actualActive,
  const String &commandId,
  const char *reason
);
void serviceSpffActuatorStateChanges(bool forcePoll = false);
void processSpffCommandLine(const String &line);
void processSpffScheduleSyncLine(
  const String &line,
  size_t rootStart,
  size_t rootEnd
);
void processSpffAutomaticControlSyncLine(
  const String &line,
  size_t rootStart,
  size_t rootEnd
);
void loadSpffSyncedSchedules();
void serviceSpffSyncedScheduleOutput();
void loadSpffAutomaticControl();
void loadSpffAutomaticDailyState();
void serviceSpffAutomaticControl();
bool sendSpffActuatorAckAt(
  const String &commandId,
  const String &targetId,
  const char *acknowledgedAt,
  const char *status,
  bool actualStateKnown,
  bool actualActive,
  const char *reason
);
bool sendSpffActuatorAck(
  const String &commandId,
  const String &targetId,
  const char *status,
  bool actualStateKnown,
  bool actualActive,
  const char *reason,
  String *acknowledgedAtOut = nullptr
);
String spffUtcIso8601();
uint32_t spffUtcEpoch();

bool rtcRead(RTCDateTime &dt);
bool rtcWrite(const RTCDateTime &dt);
RTCDateTime compileDateTime();
bool rtcDateLooksSane(const RTCDateTime &dt);

bool scheduleDayEnabled(
  const WeeklySchedule &schedule,
  uint8_t weekdayIndex
);

bool buttonRawPressed(
  const ButtonState &b
);

void handleButton(
  ButtonId id
);

void serviceOneButton(
  ButtonState &b,
  ButtonId id
);

uint8_t countFreshSoil(
  const SoilData &soil
);

uint8_t countSoilHave(
  const SoilData &soil
);

bool allSoilHaveData(
  const SoilData &soil
);

String staleSoilRegs(
  const SoilData &soil
);

void refreshSoilFreshFlags(
  uint8_t number,
  SoilData &soil
);

bool registerAlreadyChosen(
  uint8_t reg,
  const uint8_t chosen[SOIL_REGS_PER_CYCLE],
  uint8_t chosenCount
);

bool chooseMissingRegister(
  uint8_t number,
  const SoilData &soil,
  const uint8_t chosen[SOIL_REGS_PER_CYCLE],
  uint8_t chosenCount,
  uint8_t &regOut
);

bool chooseOldestRegister(
  uint8_t number,
  const SoilData &soil,
  const uint8_t chosen[SOIL_REGS_PER_CYCLE],
  uint8_t chosenCount,
  uint8_t &selected
);

uint8_t buildSoilTargetList(
  uint8_t number,
  const SoilData &soil,
  uint8_t target[SOIL_REGS_PER_CYCLE]
);

bool readSoil(
  uint8_t number,
  uint8_t sensorId,
  SoilData &soil
);

String soilStateText(
  const SoilData &soil
);

void renderSoilDetail(
  uint8_t number,
  const SoilData &soil
);

void loadSoilNVS(
  uint8_t number,
  SoilData &soil
);

void serviceButtons();
void renderUI();

void initBuzzer();
void serviceBuzzer();
void beepButton();
void serviceLCDRefresh();
void uiDelay(uint32_t ms);
String rtcTimeText(bool withSeconds = true);
String rtcDateText();

WeeklySchedule defaultScheduleFor(uint8_t index);
void loadWeeklyTimerNVS();
void saveScheduleNVS(uint8_t index);
void saveTimerModeNVS();
void clearProgram(uint8_t index);
void clearAllPrograms();

bool weeklyScheduleActive(uint8_t index);
int8_t activeScheduleIndex();
bool timerOutputActive();
void serviceIrrigationTimerOutput();

const char* timerModeText(TimerMode mode);

void openScheduleEditor(uint8_t index);
void changeScheduleValue(int delta);
void commitScheduleEditor();

void openRtcEditor();
void changeRtcValue(int delta);
bool saveRtcEditor();

uint8_t daysInMonth(uint8_t month, uint8_t year2);

// =============================================================================
// UTILITY
// =============================================================================
bool i2cExists(uint8_t address) {
  Wire.beginTransmission(address);
  return Wire.endTransmission() == 0;
}

uint8_t bcdToDec(uint8_t value) {
  return ((value >> 4) * 10U) + (value & 0x0F);
}

uint8_t decToBcd(uint8_t value) {
  return ((value / 10U) << 4) | (value % 10U);
}

String pad2(uint8_t value) {
  if (value < 10) return "0" + String(value);
  return String(value);
}

// =============================================================================
// RTC PCF85063 @ 0x51
// =============================================================================
bool rtcRead(RTCDateTime &dt) {
  if (!rtcReady) return false;

  Wire.beginTransmission(RTC_ADDR);
  Wire.write(RTC_SECONDS_REG);

  if (Wire.endTransmission(false) != 0) {
    return false;
  }

  uint8_t requested = Wire.requestFrom((int)RTC_ADDR, 7);
  if (requested != 7) return false;

  uint8_t secRaw = Wire.read();
  uint8_t minRaw = Wire.read();
  uint8_t hourRaw = Wire.read();
  uint8_t dayRaw = Wire.read();
  uint8_t weekRaw = Wire.read();
  uint8_t monthRaw = Wire.read();
  uint8_t yearRaw = Wire.read();

  dt.oscillatorStopped = (secRaw & 0x80) != 0;
  dt.second = bcdToDec(secRaw & 0x7F);
  dt.minute = bcdToDec(minRaw & 0x7F);
  dt.hour = bcdToDec(hourRaw & 0x3F);
  dt.day = bcdToDec(dayRaw & 0x3F);
  dt.weekday = weekRaw & 0x07;
  dt.month = bcdToDec(monthRaw & 0x1F);
  dt.year = bcdToDec(yearRaw);

  dt.valid =
    dt.second < 60 &&
    dt.minute < 60 &&
    dt.hour < 24 &&
    dt.day >= 1 && dt.day <= 31 &&
    dt.month >= 1 && dt.month <= 12 &&
    dt.year <= 99;

  return dt.valid;
}

bool rtcWrite(const RTCDateTime &dt) {
  if (!rtcReady) return false;

  Wire.beginTransmission(RTC_ADDR);
  Wire.write(RTC_SECONDS_REG);
  Wire.write(decToBcd(dt.second) & 0x7F);
  Wire.write(decToBcd(dt.minute) & 0x7F);
  Wire.write(decToBcd(dt.hour) & 0x3F);
  Wire.write(decToBcd(dt.day) & 0x3F);
  Wire.write(dt.weekday & 0x07);
  Wire.write(decToBcd(dt.month) & 0x1F);
  Wire.write(decToBcd(dt.year));

  return Wire.endTransmission() == 0;
}

uint8_t compileMonth(const char *month3) {
  static const char *months[] = {
    "Jan","Feb","Mar","Apr","May","Jun",
    "Jul","Aug","Sep","Oct","Nov","Dec"
  };

  for (uint8_t i = 0; i < 12; i++) {
    if (strncmp(month3, months[i], 3) == 0) return i + 1;
  }

  return 1;
}

RTCDateTime compileDateTime() {
  RTCDateTime dt;

  char month[4] = {__DATE__[0], __DATE__[1], __DATE__[2], '\0'};
  dt.month = compileMonth(month);

  dt.day =
    (__DATE__[4] == ' ' ? 0 : (__DATE__[4] - '0') * 10) +
    (__DATE__[5] - '0');

  int fullYear =
    (__DATE__[7] - '0') * 1000 +
    (__DATE__[8] - '0') * 100 +
    (__DATE__[9] - '0') * 10 +
    (__DATE__[10] - '0');

  dt.year = (uint8_t)(fullYear % 100);

  dt.hour = (__TIME__[0] - '0') * 10 + (__TIME__[1] - '0');
  dt.minute = (__TIME__[3] - '0') * 10 + (__TIME__[4] - '0');
  dt.second = (__TIME__[6] - '0') * 10 + (__TIME__[7] - '0');
  dt.weekday = 0;
  dt.valid = true;
  dt.oscillatorStopped = false;

  return dt;
}

bool rtcDateLooksSane(const RTCDateTime &dt) {
  // Project deployed in 2026; values such as year 00 normally mean the RTC
  // has never been initialized. Keep a broad lower bound so the RTC remains
  // battery-backed after a normal reboot.
  return
    dt.valid &&
    dt.year >= 24 &&
    dt.year <= 99;
}

void initRTC() {
  rtcReady = i2cExists(RTC_ADDR);

  if (!rtcReady) {
    return;
  }

  RTCDateTime dt;

  bool readOk = rtcRead(dt);

  if (
    !readOk ||
    dt.oscillatorStopped ||
    !rtcDateLooksSane(dt)
  ) {
    RTCDateTime compiled = compileDateTime();

    if (rtcWrite(compiled)) {
      rtcNow = compiled;
    } else {
    }
  } else {
    rtcNow = dt;
  }

}

void updateRTC() {
  RTCDateTime dt;
  if (rtcRead(dt)) rtcNow = dt;
}

String rtcTimeText(bool withSeconds) {
  if (!rtcReady || !rtcNow.valid) return "--:--:--";

  String value = pad2(rtcNow.hour) + ":" + pad2(rtcNow.minute);
  if (withSeconds) value += ":" + pad2(rtcNow.second);
  return value;
}

String rtcDateText() {
  if (!rtcReady || !rtcNow.valid) return "--/--/--";
  return pad2(rtcNow.day) + "/" + pad2(rtcNow.month) + "/" + pad2(rtcNow.year);
}


// =============================================================================
// W5500 ETHERNET + ASYNC NTP -> RTC
// =============================================================================
// IMPORTANT:
// - Semua operasi DHCP/DNS/NTP yang dapat blocking dijalankan di background task.
// - Main loop hanya membaca status cache dan menerapkan epoch NTP ke RTC.
// - I2C RTC tetap ditulis dari main loop agar tidak race dengan LCD/RTC sensor logic.

static bool ethernetUsableRaw() {
  if (!SPFF_ENABLE_ETHERNET_RUNTIME) {
    return false;
  }

  if (Ethernet.hardwareStatus() == EthernetNoHardware) {
    return false;
  }

  if (Ethernet.linkStatus() == LinkOFF) {
    return false;
  }

  const IPAddress ip = Ethernet.localIP();
  return ip[0] != 0 || ip[1] != 0 || ip[2] != 0 || ip[3] != 0;
}

bool ethernetUsable() {
  return
    SPFF_ENABLE_ETHERNET_RUNTIME &&
    ethernetInitialized &&
    ethernetHasAddress;
}

void buildEthernetMac(uint8_t mac[6]) {
  const uint64_t efuseMac = ESP.getEfuseMac();

  // Locally administered unicast MAC derived deterministically from ESP eFuse.
  mac[0] = 0x02;
  mac[1] = (uint8_t)(efuseMac >> 32);
  mac[2] = (uint8_t)(efuseMac >> 24);
  mac[3] = (uint8_t)(efuseMac >> 16);
  mac[4] = (uint8_t)(efuseMac >> 8);
  mac[5] = (uint8_t)(efuseMac);
}

void initEthernet() {
  if (!SPFF_ENABLE_ETHERNET_RUNTIME) {
    ethernetInitialized = false;
    ethernetHasAddress = false;
    return;
  }

  lastEthernetDhcpAttemptMs = millis();

  pinMode(ETH_CS_PIN, OUTPUT);
  digitalWrite(ETH_CS_PIN, HIGH);
  pinMode(ETH_INT_PIN, INPUT_PULLUP);

  SPI.begin(
    ETH_SCLK_PIN,
    ETH_MISO_PIN,
    ETH_MOSI_PIN,
    ETH_CS_PIN
  );

  Ethernet.init(ETH_CS_PIN);

  uint8_t mac[6];
  buildEthernetMac(mac);

  // Bisa blocking beberapa detik, tetapi fungsi ini hanya dipanggil dari
  // background task sehingga tidak menahan tombol/LCD/control loop.
  const int dhcpOk = Ethernet.begin(
    mac,
    5000UL,
    1500UL
  );

  ethernetInitialized =
    Ethernet.hardwareStatus() != EthernetNoHardware;

  ethernetHasAddress =
    dhcpOk != 0 &&
    ethernetUsableRaw();

  lastEthernetMaintainMs = millis();
}

void serviceEthernet() {
  if (!SPFF_ENABLE_ETHERNET_RUNTIME) {
    return;
  }

  const uint32_t now = millis();

  if (!ethernetInitialized) {
    if (
      lastEthernetDhcpAttemptMs == 0 ||
      (uint32_t)(now - lastEthernetDhcpAttemptMs) >=
        ETHERNET_RETRY_INTERVAL_MS
    ) {
      initEthernet();
    }
    return;
  }

  // Jika W5500 ada tetapi DHCP/link belum usable, lakukan bounded DHCP retry.
  if (!ethernetHasAddress) {
    if (
      lastEthernetDhcpAttemptMs == 0 ||
      (uint32_t)(now - lastEthernetDhcpAttemptMs) >=
        ETHERNET_RETRY_INTERVAL_MS
    ) {
      initEthernet();
    }
    return;
  }

  if (
    (uint32_t)(now - lastEthernetMaintainMs) <
    ETHERNET_MAINTAIN_INTERVAL_MS
  ) {
    return;
  }

  lastEthernetMaintainMs = now;

  // DHCP renew/rebind juga hanya berjalan di background network task.
  (void)Ethernet.maintain();
  ethernetHasAddress = ethernetUsableRaw();
}

static void buildNtpPacket(uint8_t packet[48]) {
  memset(packet, 0, 48);
  packet[0] = 0b11100011; // LI=3, Version=4, Mode=3 client
  packet[1] = 0;
  packet[2] = 6;
  packet[3] = 0xEC;
  packet[12] = 49;
  packet[13] = 0x4E;
  packet[14] = 49;
  packet[15] = 52;
}

template <typename UdpType>
bool ntpQuery(
  UdpType &udp,
  const IPAddress &serverIp,
  uint32_t &unixEpochOut
) {
  uint8_t packet[48];
  buildNtpPacket(packet);

  udp.stop();

  if (!udp.begin(NTP_LOCAL_PORT)) {
    return false;
  }

  if (!udp.beginPacket(serverIp, 123)) {
    udp.stop();
    return false;
  }

  udp.write(packet, sizeof(packet));

  if (!udp.endPacket()) {
    udp.stop();
    return false;
  }

  const uint32_t started = millis();

  while (
    (uint32_t)(millis() - started) <
    NTP_RESPONSE_TIMEOUT_MS
  ) {
    const int packetSize = udp.parsePacket();

    if (packetSize >= 48) {
      uint8_t response[48];
      const int readLen = udp.read(response, sizeof(response));
      udp.stop();

      if (readLen < 48) {
        return false;
      }

      const uint32_t ntpSeconds =
        ((uint32_t)response[40] << 24) |
        ((uint32_t)response[41] << 16) |
        ((uint32_t)response[42] << 8) |
        (uint32_t)response[43];

      static constexpr uint32_t NTP_UNIX_EPOCH_DELTA = 2208988800UL;

      if (ntpSeconds <= NTP_UNIX_EPOCH_DELTA) {
        return false;
      }

      unixEpochOut =
        ntpSeconds -
        NTP_UNIX_EPOCH_DELTA;

      return true;
    }

    // Jangan memanggil UI/I2C/command handler dari task network.
    // Yield hanya task ini; main loop tetap berjalan normal di core aplikasi.
    vTaskDelay(pdMS_TO_TICKS(2));
  }

  udp.stop();
  return false;
}

bool writeRtcFromUtcEpoch(uint32_t utcEpoch) {
  if (!rtcReady || utcEpoch == 0) {
    return false;
  }

  // RTC intentionally stored as Asia/Jakarta local time (UTC+7)
  // to preserve existing local schedule/UI behavior.
  const time_t localEpoch =
    (time_t)utcEpoch +
    (time_t)SPFF_LOCAL_UTC_OFFSET_MINUTES * 60;

  struct tm localTm;
  memset(&localTm, 0, sizeof(localTm));

  if (gmtime_r(&localEpoch, &localTm) == nullptr) {
    return false;
  }

  const int fullYear = localTm.tm_year + 1900;

  if (
    fullYear < 2024 ||
    fullYear > 2099
  ) {
    return false;
  }

  RTCDateTime dt;
  dt.second = (uint8_t)localTm.tm_sec;
  dt.minute = (uint8_t)localTm.tm_min;
  dt.hour = (uint8_t)localTm.tm_hour;
  dt.day = (uint8_t)localTm.tm_mday;

  // tm_wday: Sunday=0. RTC/UI convention: Monday=0 ... Sunday=6.
  dt.weekday =
    localTm.tm_wday == 0
      ? 6
      : (uint8_t)(localTm.tm_wday - 1);

  dt.month = (uint8_t)(localTm.tm_mon + 1);
  dt.year = (uint8_t)(fullYear - 2000);
  dt.valid = true;
  dt.oscillatorStopped = false;

  if (!rtcWrite(dt)) {
    return false;
  }

  rtcNow = dt;
  return true;
}

bool resolveNtpServer(
  const char *host,
  IPAddress &serverIp,
  bool useEthernet
) {
  // DNS bisa blocking; aman karena fungsi hanya dipanggil network task.
  if (useEthernet) {
    const IPAddress dnsServer = Ethernet.dnsServerIP();

    if (dnsServer == IPAddress(0, 0, 0, 0)) {
      return false;
    }

    DNSClient dns;
    dns.begin(dnsServer);
    return dns.getHostByName(host, serverIp) == 1;
  }

  return WiFi.hostByName(host, serverIp) == 1;
}

static void queueNtpEpoch(uint32_t utcEpoch) {
  portENTER_CRITICAL(&spffNetworkStateMux);
  pendingNtpUtcEpoch = utcEpoch;
  pendingNtpEpochReady = true;
  portEXIT_CRITICAL(&spffNetworkStateMux);
}

bool syncRtcFromNtp() {
  const bool useEthernet =
    ethernetUsable();

  const bool useWifi =
    WiFi.status() == WL_CONNECTED;

  if (!useEthernet && !useWifi) {
    return false;
  }

  const char *servers[] = {
    NTP_SERVER_PRIMARY,
    NTP_SERVER_FALLBACK
  };

  for (uint8_t i = 0; i < 2; i++) {
    IPAddress serverIp;

    if (
      !resolveNtpServer(
        servers[i],
        serverIp,
        useEthernet
      )
    ) {
      continue;
    }

    uint32_t utcEpoch = 0;
    const bool queried =
      useEthernet
        ? ntpQuery(
            ntpEthernetUdp,
            serverIp,
            utcEpoch
          )
        : ntpQuery(
            ntpWifiUdp,
            serverIp,
            utcEpoch
          );

    if (queried && utcEpoch != 0) {
      // Jangan menulis RTC/I2C dari network task.
      queueNtpEpoch(utcEpoch);
      return true;
    }
  }

  return false;
}

static void serviceNetworkTimeFromTask() {
  if (!SPFF_ENABLE_NTP_RUNTIME) {
    return;
  }

  const uint32_t now = millis();

  if (
    !ntpEverSynced &&
    lastNtpAttemptMs == 0 &&
    now < NTP_INITIAL_DELAY_MS
  ) {
    return;
  }

  const uint32_t interval =
    ntpEverSynced
      ? NTP_SYNC_INTERVAL_MS
      : NTP_RETRY_INTERVAL_MS;

  if (
    lastNtpAttemptMs != 0 &&
    (uint32_t)(now - lastNtpAttemptMs) <
      interval
  ) {
    return;
  }

  if (
    !ethernetUsable() &&
    WiFi.status() != WL_CONNECTED
  ) {
    return;
  }

  lastNtpAttemptMs = now;
  (void)syncRtcFromNtp();
}

void serviceNetworkTime() {
  // Main-loop side only: consume an NTP epoch obtained by background task
  // and write PCF85063 over I2C safely from the application task.
  uint32_t utcEpoch = 0;
  bool hasPending = false;

  portENTER_CRITICAL(&spffNetworkStateMux);
  if (pendingNtpEpochReady) {
    utcEpoch = pendingNtpUtcEpoch;
    pendingNtpEpochReady = false;
    hasPending = true;
  }
  portEXIT_CRITICAL(&spffNetworkStateMux);

  if (!hasPending) {
    return;
  }

  if (writeRtcFromUtcEpoch(utcEpoch)) {
    ntpEverSynced = true;
    lastNtpSuccessMs = millis();
    lcdDirty = true;
  }
}

void spffNetworkTask(void *parameter) {
  (void)parameter;

  // Delay kecil agar boot/UI/USB serial siap terlebih dahulu.
  vTaskDelay(pdMS_TO_TICKS(3000));

  if (SPFF_ENABLE_ETHERNET_RUNTIME) {
    initEthernet();
  }

  for (;;) {
    serviceEthernet();
    serviceNetworkTimeFromTask();
    vTaskDelay(pdMS_TO_TICKS(NETWORK_TASK_INTERVAL_MS));
  }
}

void startSpffNetworkTask() {
  if (
    !SPFF_ENABLE_ETHERNET_RUNTIME &&
    !SPFF_ENABLE_NTP_RUNTIME
  ) {
    return;
  }

  if (spffNetworkTaskHandle != nullptr) {
    return;
  }

  const BaseType_t result = xTaskCreatePinnedToCore(
    spffNetworkTask,
    "spff-network",
    NETWORK_TASK_STACK_BYTES,
    nullptr,
    1,
    &spffNetworkTaskHandle,
    0
  );

  if (result != pdPASS) {
    spffNetworkTaskHandle = nullptr;
    ethernetInitialized = false;
    ethernetHasAddress = false;
  }
}


// =============================================================================
// WEEKLY TIMER LOGIC
// =============================================================================
uint8_t weekdayMondayZero(
  uint8_t year2,
  uint8_t month,
  uint8_t day
) {
  // Sakamoto: 0=Sunday .. 6=Saturday.
  static const uint8_t t[] = {
    0, 3, 2, 5, 0, 3,
    5, 1, 4, 6, 2, 4
  };

  int year =
    2000 +
    year2;

  if (month < 3) {
    year -= 1;
  }

  uint8_t sundayZero =
    (uint8_t)(
      (
        year +
        year / 4 -
        year / 100 +
        year / 400 +
        t[month - 1] +
        day
      ) %
      7
    );

  // Monday=0 .. Sunday=6.
  return
    sundayZero == 0
    ? 6
    : sundayZero - 1;
}

uint8_t previousWeekday(
  uint8_t dayIndex
) {
  return
    dayIndex == 0
    ? 6
    : dayIndex - 1;
}

uint16_t buildMinute(
  uint8_t hour,
  uint8_t minute
) {
  return
    (uint16_t)(
      (hour % 24U) *
      60U +
      (minute % 60U)
    );
}

uint8_t scheduleHour(
  uint16_t minuteOfDay
) {
  return
    (minuteOfDay % 1440U) /
    60U;
}

uint8_t scheduleMinutePart(
  uint16_t minuteOfDay
) {
  return
    (minuteOfDay % 1440U) %
    60U;
}

uint8_t findDayPreset(
  uint8_t mask
) {
  for (
    uint8_t i = 0;
    i < DAY_PRESET_COUNT;
    i++
  ) {
    if (
      DAY_PRESETS[i].mask ==
      mask
    ) {
      return i;
    }
  }

  return 0;
}

bool scheduleDayEnabled(
  const WeeklySchedule &schedule,
  uint8_t weekdayIndex
) {
  if (
    weekdayIndex >
    6
  ) {
    return false;
  }

  return
    (
      schedule.daysMask &
      (uint8_t)(
        1U <<
        weekdayIndex
      )
    ) !=
    0;
}

WeeklySchedule defaultScheduleFor(
  uint8_t index
) {
  WeeklySchedule defaults;

  defaults.enabled =
    false;

  defaults.daysMask =
    0x3F;

  // Waktu default berurutan supaya 16 program mudah dibedakan.
  // Semua tetap NONAKTIF sampai operator mengaktifkannya.
  defaults.startMinute =
    (uint16_t)(
      (
        360U +
        (uint16_t)index *
        30U
      ) %
      1440U
    );

  defaults.endMinute =
    (uint16_t)(
      (
        defaults.startMinute +
        30U
      ) %
      1440U
    );

  return defaults;
}

bool weeklyScheduleActive(
  uint8_t index
) {
  if (
    index >=
      WEEKLY_SCHEDULE_COUNT ||
    !rtcReady ||
    !rtcNow.valid
  ) {
    return false;
  }

  const WeeklySchedule &schedule =
    weeklySchedules[index];

  if (
    !schedule.enabled
  ) {
    return false;
  }

  uint8_t today =
    weekdayMondayZero(
      rtcNow.year,
      rtcNow.month,
      rtcNow.day
    );

  uint16_t nowMinute =
    (uint16_t)rtcNow.hour *
    60U +
    rtcNow.minute;

  uint16_t start =
    schedule.startMinute %
    1440U;

  uint16_t finish =
    schedule.endMinute %
    1440U;

  // Jam aktif == jam nonaktif dianggap program kosong.
  if (
    start ==
    finish
  ) {
    return false;
  }

  // Jadwal dalam hari yang sama.
  if (
    start <
    finish
  ) {
    return
      scheduleDayEnabled(
        schedule,
        today
      ) &&
      nowMinute >=
        start &&
      nowMinute <
        finish;
  }

  // Jadwal melewati tengah malam.
  // Contoh Senin 23:00 -> Selasa 01:00.
  if (
    nowMinute >=
    start
  ) {
    return
      scheduleDayEnabled(
        schedule,
        today
      );
  }

  return
    nowMinute <
      finish &&
    scheduleDayEnabled(
      schedule,
      previousWeekday(
        today
      )
    );
}

int8_t activeScheduleIndex() {
  for (
    uint8_t i = 0;
    i < WEEKLY_SCHEDULE_COUNT;
    i++
  ) {
    if (
      weeklyScheduleActive(
        i
      )
    ) {
      return
        (int8_t)i;
    }
  }

  return -1;
}

const char* timerModeText(
  TimerMode mode
) {
  if (SPFF_DISABLE_LEGACY_LOCAL_TIMER) {
    return "BACKEND";
  }

  switch (mode) {
    case TIMER_MODE_FORCE_ON:
      return "PAKSA AKTIF";

    case TIMER_MODE_FORCE_OFF:
      return "PAKSA NONAKTIF";

    case TIMER_MODE_AUTO:
    default:
      return "OTOMATIS";
  }
}

bool timerOutputActive() {
  switch (timerMode) {
    case TIMER_MODE_FORCE_ON:
      return true;

    case TIMER_MODE_FORCE_OFF:
      return false;

    case TIMER_MODE_AUTO:
    default:
      return
        activeScheduleIndex() >=
        0;
  }
}

// Nama lama dipertahankan supaya integrasi berikutnya tidak perlu dirombak.
void loadWeeklyTimerNVS() {
  for (
    uint8_t i = 0;
    i < WEEKLY_SCHEDULE_COUNT;
    i++
  ) {
    WeeklySchedule defaults =
      defaultScheduleFor(i);

    String prefix =
      "j" +
      String(i + 1);

    weeklySchedules[i].enabled =
      prefs.getBool(
        (prefix + "en").c_str(),
        defaults.enabled
      );

    weeklySchedules[i].daysMask =
      prefs.getUChar(
        (prefix + "day").c_str(),
        defaults.daysMask
      );

    weeklySchedules[i].startMinute =
      prefs.getUShort(
        (prefix + "start").c_str(),
        defaults.startMinute
      );

    weeklySchedules[i].endMinute =
      prefs.getUShort(
        (prefix + "end").c_str(),
        defaults.endMinute
      );

    if (
      weeklySchedules[i].daysMask ==
        0 ||
      weeklySchedules[i].daysMask >
        0x7F
    ) {
      weeklySchedules[i].daysMask =
        defaults.daysMask;
    }

    weeklySchedules[i].startMinute %=
      1440U;

    weeklySchedules[i].endMinute %=
      1440U;
  }

  uint8_t storedMode =
    prefs.getUChar(
      "timer_mode",
      (uint8_t)TIMER_MODE_AUTO
    );

  if (
    storedMode >
    (uint8_t)TIMER_MODE_FORCE_OFF
  ) {
    storedMode =
      (uint8_t)TIMER_MODE_AUTO;
  }

  timerMode =
    (TimerMode)storedMode;

  editTimerMode =
    timerMode;
}

void saveScheduleNVS(
  uint8_t index
) {
  if (
    index >=
    WEEKLY_SCHEDULE_COUNT
  ) {
    return;
  }

  String prefix =
    "j" +
    String(index + 1);

  prefs.putBool(
    (prefix + "en").c_str(),
    weeklySchedules[index].enabled
  );

  prefs.putUChar(
    (prefix + "day").c_str(),
    weeklySchedules[index].daysMask
  );

  prefs.putUShort(
    (prefix + "start").c_str(),
    weeklySchedules[index].startMinute
  );

  prefs.putUShort(
    (prefix + "end").c_str(),
    weeklySchedules[index].endMinute
  );
}

void saveTimerModeNVS() {
  prefs.putUChar(
    "timer_mode",
    (uint8_t)timerMode
  );
}

void clearProgram(
  uint8_t index
) {
  if (
    index >=
    WEEKLY_SCHEDULE_COUNT
  ) {
    return;
  }

  weeklySchedules[index] =
    defaultScheduleFor(
      index
    );

  saveScheduleNVS(
    index
  );

}

void clearAllPrograms() {
  for (
    uint8_t i = 0;
    i < WEEKLY_SCHEDULE_COUNT;
    i++
  ) {
    weeklySchedules[i] =
      defaultScheduleFor(i);

    saveScheduleNVS(i);
  }

}

void openScheduleEditor(
  uint8_t index
) {
  if (
    index >=
    WEEKLY_SCHEDULE_COUNT
  ) {
    return;
  }

  scheduleEditIndex =
    index;

  editSchedule =
    weeklySchedules[index];

  scheduleEditField =
    0;

  scheduleValueEditing =
    false;
}

void changeScheduleValue(
  int delta
) {
  uint8_t startHour =
    scheduleHour(
      editSchedule.startMinute
    );

  uint8_t startMinute =
    scheduleMinutePart(
      editSchedule.startMinute
    );

  uint8_t endHour =
    scheduleHour(
      editSchedule.endMinute
    );

  uint8_t endMinute =
    scheduleMinutePart(
      editSchedule.endMinute
    );

  switch (
    scheduleEditField
  ) {
    case 0:
      editSchedule.enabled =
        !editSchedule.enabled;
      break;

    case 1: {
      uint8_t preset =
        findDayPreset(
          editSchedule.daysMask
        );

      int next =
        (int)preset +
        delta;

      if (
        next <
        0
      ) {
        next =
          DAY_PRESET_COUNT -
          1;
      }

      if (
        next >=
        DAY_PRESET_COUNT
      ) {
        next = 0;
      }

      editSchedule.daysMask =
        DAY_PRESETS[next].mask;
      break;
    }

    case 2: {
      int next =
        (int)startHour +
        delta;

      if (
        next <
        0
      ) {
        next = 23;
      }

      if (
        next >
        23
      ) {
        next = 0;
      }

      editSchedule.startMinute =
        buildMinute(
          (uint8_t)next,
          startMinute
        );
      break;
    }

    case 3: {
      int next =
        (int)startMinute +
        delta;

      if (
        next <
        0
      ) {
        next = 59;
      }

      if (
        next >
        59
      ) {
        next = 0;
      }

      editSchedule.startMinute =
        buildMinute(
          startHour,
          (uint8_t)next
        );
      break;
    }

    case 4: {
      int next =
        (int)endHour +
        delta;

      if (
        next <
        0
      ) {
        next = 23;
      }

      if (
        next >
        23
      ) {
        next = 0;
      }

      editSchedule.endMinute =
        buildMinute(
          (uint8_t)next,
          endMinute
        );
      break;
    }

    case 5: {
      int next =
        (int)endMinute +
        delta;

      if (
        next <
        0
      ) {
        next = 59;
      }

      if (
        next >
        59
      ) {
        next = 0;
      }

      editSchedule.endMinute =
        buildMinute(
          endHour,
          (uint8_t)next
        );
      break;
    }
  }
}

void commitScheduleEditor() {
  if (
    scheduleEditIndex >=
    WEEKLY_SCHEDULE_COUNT
  ) {
    return;
  }

  weeklySchedules[
    scheduleEditIndex
  ] =
    editSchedule;

  saveScheduleNVS(
    scheduleEditIndex
  );

}

bool leapYear(
  uint16_t fullYear
) {
  return
    (
      fullYear %
      400U
    ) ==
      0U ||
    (
      (
        fullYear %
        4U
      ) ==
        0U &&
      (
        fullYear %
        100U
      ) !=
        0U
    );
}

uint8_t daysInMonth(
  uint8_t month,
  uint8_t year2
) {
  static const uint8_t days[] = {
    31, 28, 31, 30,
    31, 30, 31, 31,
    30, 31, 30, 31
  };

  if (
    month <
      1 ||
    month >
      12
  ) {
    return 31;
  }

  if (
    month ==
      2 &&
    leapYear(
      2000U +
      year2
    )
  ) {
    return 29;
  }

  return
    days[
      month -
      1
    ];
}

void normalizeRtcEditDay() {
  uint8_t maximum =
    daysInMonth(
      editRtc.month,
      editRtc.year
    );

  if (
    editRtc.day <
    1
  ) {
    editRtc.day =
      maximum;
  }

  if (
    editRtc.day >
    maximum
  ) {
    editRtc.day =
      1;
  }
}

void openRtcEditor() {
  if (
    rtcReady &&
    rtcNow.valid
  ) {
    editRtc =
      rtcNow;
  } else {
    editRtc =
      compileDateTime();
  }

  editRtc.second =
    0;

  rtcEditField =
    0;

  rtcValueEditing =
    false;
}

void changeRtcValue(
  int delta
) {
  switch (
    rtcEditField
  ) {
    case 0: {
      int next =
        (int)editRtc.day +
        delta;

      uint8_t maximum =
        daysInMonth(
          editRtc.month,
          editRtc.year
        );

      if (
        next <
        1
      ) {
        next =
          maximum;
      }

      if (
        next >
        maximum
      ) {
        next = 1;
      }

      editRtc.day =
        (uint8_t)next;
      break;
    }

    case 1: {
      int next =
        (int)editRtc.month +
        delta;

      if (
        next <
        1
      ) {
        next = 12;
      }

      if (
        next >
        12
      ) {
        next = 1;
      }

      editRtc.month =
        (uint8_t)next;

      normalizeRtcEditDay();
      break;
    }

    case 2: {
      int next =
        (int)editRtc.year +
        delta;

      if (
        next <
        24
      ) {
        next = 99;
      }

      if (
        next >
        99
      ) {
        next = 24;
      }

      editRtc.year =
        (uint8_t)next;

      normalizeRtcEditDay();
      break;
    }

    case 3: {
      int next =
        (int)editRtc.hour +
        delta;

      if (
        next <
        0
      ) {
        next = 23;
      }

      if (
        next >
        23
      ) {
        next = 0;
      }

      editRtc.hour =
        (uint8_t)next;
      break;
    }

    case 4: {
      int next =
        (int)editRtc.minute +
        delta;

      if (
        next <
        0
      ) {
        next = 59;
      }

      if (
        next >
        59
      ) {
        next = 0;
      }

      editRtc.minute =
        (uint8_t)next;
      break;
    }
  }
}

bool saveRtcEditor() {
  if (
    !rtcReady
  ) {

    return false;
  }

  normalizeRtcEditDay();

  editRtc.second =
    0;

  editRtc.weekday =
    weekdayMondayZero(
      editRtc.year,
      editRtc.month,
      editRtc.day
    );

  editRtc.valid =
    true;

  editRtc.oscillatorStopped =
    false;

  if (
    !rtcWrite(
      editRtc
    )
  ) {

    return false;
  }

  rtcNow =
    editRtc;


  return true;
}


String rtcHeader() {
  return rtcTimeText(true) + " " + rtcDateText();
}

// =============================================================================
// BUTTONS
// =============================================================================
ButtonState btnCancel(BTN_CANCEL_PIN);
ButtonState btnOk(BTN_OK_PIN);
ButtonState btnUp(BTN_UP_PIN);
ButtonState btnDown(BTN_DOWN_PIN);

// Lebih responsif daripada nilai lama 60 ms, tetapi masih aman dari bounce.
static constexpr uint32_t BUTTON_DEBOUNCE_MS = 25UL;

// Tahan UP/DOWN:
// - satu aksi langsung saat ditekan
// - setelah 320 ms mulai auto-repeat
// - makin lama ditahan, repeat makin cepat
static constexpr uint32_t BUTTON_HOLD_START_MS = 320UL;
static constexpr uint32_t BUTTON_REPEAT_NORMAL_MS = 95UL;
static constexpr uint32_t BUTTON_REPEAT_FAST_MS = 55UL;
static constexpr uint32_t BUTTON_REPEAT_TURBO_MS = 35UL;
static constexpr uint32_t BUTTON_FAST_AFTER_MS = 1200UL;
static constexpr uint32_t BUTTON_TURBO_AFTER_MS = 2800UL;

uint32_t buzzerOffAtMs = 0;
bool buzzerIsOn = false;

void initBuzzer() {
  // ESP32 Arduino Core lama:
  // setup channel -> attach pin -> tone OFF.
  ledcSetup(
    BUZZER_CHANNEL,
    BUZZER_FREQ_HZ,
    BUZZER_RESOLUTION_BITS
  );
  ledcAttachPin(
    BUZZER_PIN,
    BUZZER_CHANNEL
  );
  ledcWriteTone(
    BUZZER_CHANNEL,
    0
  );

  buzzerIsOn = false;
  buzzerOffAtMs = 0;
}

void beepButton() {
  // Restart tone setiap kali ada PRESS fisik.
  ledcWriteTone(
    BUZZER_CHANNEL,
    BUZZER_FREQ_HZ
  );

  buzzerIsOn = true;
  buzzerOffAtMs =
    millis() + BUTTON_BEEP_MS;
}

void serviceBuzzer() {
  if (
    buzzerIsOn &&
    (int32_t)(millis() - buzzerOffAtMs) >= 0
  ) {
    ledcWriteTone(
      BUZZER_CHANNEL,
      0
    );

    buzzerIsOn = false;
  }
}

enum UIScreen {
  UI_MAIN,

  // Menu utama baru:
  // 1) Monitoring seluruh sensor
  // 2) Status seluruh sensor
  // 3) Pengaturan
  UI_MONITOR,
  UI_SENSOR_STATUS,
  UI_SETTINGS,

  // Screen legacy tetap dipertahankan agar fungsi lama tidak rusak.
  UI_SOIL_MENU,
  UI_SOIL1,
  UI_SOIL2,
  UI_TANK_FLOW,
  UI_SYSTEM,

  UI_TIMER_MENU,
  UI_TIMER_MODE,
  UI_SCHEDULE_EDIT,
  UI_RTC_EDIT,
  UI_CLEAR_PROGRAM,
  UI_CLEAR_ALL,
  UI_TIMER_STATUS,

  UI_CALIBRATION_MENU,
  UI_CALIBRATION_INFO,
  UI_WIFI_OTA,

  UI_BUTTON_TEST,
  UI_ABOUT
};

UIScreen uiScreen =
  UI_MAIN;

UIScreen rtcReturnScreen =
  UI_TIMER_MENU;

const char *MAIN_ITEMS[] = {
  "Monitoring",
  "Status Sensor",
  "Pengaturan"
};

static constexpr uint8_t MAIN_COUNT =
  3;

const char *SOIL_ITEMS[] = {
  "Sensor Tanah 1",
  "Sensor Tanah 2"
};

const char *SETTING_ITEMS[] = {
  "Timer Mingguan",
  "Waktu & Tanggal",
  "Kalibrasi Sensor",
  "WiFi & OTA",
  "Tes Tombol",
  "Tentang"
};

static constexpr uint8_t SETTING_COUNT =
  6;

const char *CALIB_ITEMS[] = {
  "Nutrisi pH/EC/T",
  "Udara T/RH",
  "Tanah 1 (7-in-1)",
  "Tanah 2 (7-in-1)",
  "Level Tandon",
  "Flow Air/Pupuk"
};

static constexpr uint8_t CALIB_COUNT =
  6;

uint8_t calibIndex = 0;

const char *TIMER_ITEMS[] = {
  "Mode Timer",
  "Program 1",
  "Program 2",
  "Program 3",
  "Program 4",
  "Program 5",
  "Program 6",
  "Program 7",
  "Program 8",
  "Program 9",
  "Program 10",
  "Program 11",
  "Program 12",
  "Program 13",
  "Program 14",
  "Program 15",
  "Program 16",
  "Atur Jam & Tanggal",
  "Hapus Program",
  "Hapus Semua",
  "Status Timer"
};

static constexpr uint8_t TIMER_MENU_COUNT =
  21;

uint8_t mainIndex =
  0;

// Monitoring sekarang manual: UP/DOWN memilih halaman sensor.
// Tidak lagi berpindah otomatis berdasarkan millis().
static constexpr uint8_t MONITOR_PAGE_COUNT =
  7;

uint8_t monitorPageIndex =
  0;

uint8_t soilIndex =
  0;

uint8_t settingIndex =
  0;

bool buttonRawPressed(
  const ButtonState &b
) {
  return
    digitalRead(
      b.pin
    ) ==
    LOW;
}

void initButtons() {
  pinMode(
    BTN_CANCEL_PIN,
    INPUT_PULLUP
  );

  pinMode(
    BTN_OK_PIN,
    INPUT_PULLUP
  );

  pinMode(
    BTN_UP_PIN,
    INPUT_PULLUP
  );

  pinMode(
    BTN_DOWN_PIN,
    INPUT_PULLUP
  );

  delay(100);

  btnCancel.lastRawPressed =
    buttonRawPressed(
      btnCancel
    );

  btnOk.lastRawPressed =
    buttonRawPressed(
      btnOk
    );

  btnUp.lastRawPressed =
    buttonRawPressed(
      btnUp
    );

  btnDown.lastRawPressed =
    buttonRawPressed(
      btnDown
    );

  // Sinkronkan stable state saat boot.
  btnCancel.stablePressed = btnCancel.lastRawPressed;
  btnOk.stablePressed     = btnOk.lastRawPressed;
  btnUp.stablePressed     = btnUp.lastRawPressed;
  btnDown.stablePressed   = btnDown.lastRawPressed;

}

void moveSelection(
  uint8_t &index,
  uint8_t count,
  int delta
) {
  if (
    count ==
    0
  ) {
    return;
  }

  int next =
    (int)index +
    delta;

  if (
    next <
    0
  ) {
    next =
      count -
      1;
  }

  if (
    next >=
    count
  ) {
    next = 0;
  }

  index =
    (uint8_t)next;
}

void handleButton(
  ButtonId id
) {
  switch (
    uiScreen
  ) {
    case UI_MAIN:
      if (
        id ==
        BUTTON_UP
      ) {
        moveSelection(
          mainIndex,
          MAIN_COUNT,
          -1
        );
      }

      if (
        id ==
        BUTTON_DOWN
      ) {
        moveSelection(
          mainIndex,
          MAIN_COUNT,
          +1
        );
      }

      if (
        id ==
        BUTTON_OK
      ) {
        switch (
          mainIndex
        ) {
          case 0:
            monitorPageIndex =
              0;

            uiScreen =
              UI_MONITOR;
            break;

          case 1:
            uiScreen =
              UI_SENSOR_STATUS;
            break;

          case 2:
            uiScreen =
              UI_SETTINGS;
            break;
        }
      }
      break;

    case UI_MONITOR:
      if (
        id ==
        BUTTON_UP
      ) {
        moveSelection(
          monitorPageIndex,
          MONITOR_PAGE_COUNT,
          -1
        );
      }

      if (
        id ==
        BUTTON_DOWN
      ) {
        moveSelection(
          monitorPageIndex,
          MONITOR_PAGE_COUNT,
          +1
        );
      }

      if (
        id ==
        BUTTON_CANCEL
      ) {
        uiScreen =
          UI_MAIN;
      }
      break;

    case UI_SENSOR_STATUS:
    case UI_TANK_FLOW:
    case UI_SYSTEM:
    case UI_SOIL1:
    case UI_SOIL2:
    case UI_BUTTON_TEST:
    case UI_ABOUT:
      if (
        id ==
        BUTTON_CANCEL
      ) {
        uiScreen =
          UI_MAIN;
      }
      break;

    case UI_SOIL_MENU:
      if (
        id ==
        BUTTON_UP
      ) {
        moveSelection(
          soilIndex,
          2,
          -1
        );
      }

      if (
        id ==
        BUTTON_DOWN
      ) {
        moveSelection(
          soilIndex,
          2,
          +1
        );
      }

      if (
        id ==
        BUTTON_CANCEL
      ) {
        uiScreen =
          UI_MAIN;
      }

      if (
        id ==
        BUTTON_OK
      ) {
        uiScreen =
          soilIndex ==
            0
          ? UI_SOIL1
          : UI_SOIL2;
      }
      break;

    case UI_SETTINGS:
      if (
        id ==
        BUTTON_UP
      ) {
        moveSelection(
          settingIndex,
          SETTING_COUNT,
          -1
        );
      }

      if (
        id ==
        BUTTON_DOWN
      ) {
        moveSelection(
          settingIndex,
          SETTING_COUNT,
          +1
        );
      }

      if (
        id ==
        BUTTON_CANCEL
      ) {
        uiScreen =
          UI_MAIN;
      }

      if (
        id ==
        BUTTON_OK
      ) {
        switch (
          settingIndex
        ) {
          case 0:
            uiScreen =
              UI_TIMER_MENU;
            break;

          case 1:
            rtcReturnScreen =
              UI_SETTINGS;

            openRtcEditor();

            uiScreen =
              UI_RTC_EDIT;
            break;

          case 2:
            uiScreen =
              UI_CALIBRATION_MENU;
            break;

          case 3:
            uiScreen =
              UI_WIFI_OTA;
            break;

          case 4:
            uiScreen =
              UI_BUTTON_TEST;
            break;

          case 5:
            uiScreen =
              UI_ABOUT;
            break;
        }
      }
      break;

    case UI_CALIBRATION_MENU:
      if (id == BUTTON_UP) {
        moveSelection(
          calibIndex,
          CALIB_COUNT,
          -1
        );
      }

      if (id == BUTTON_DOWN) {
        moveSelection(
          calibIndex,
          CALIB_COUNT,
          +1
        );
      }

      if (id == BUTTON_CANCEL) {
        uiScreen =
          UI_SETTINGS;
      }

      if (id == BUTTON_OK) {
        uiScreen =
          UI_CALIBRATION_INFO;
      }
      break;

    case UI_CALIBRATION_INFO:
      if (
        id == BUTTON_CANCEL ||
        id == BUTTON_OK
      ) {
        uiScreen =
          UI_CALIBRATION_MENU;
      }
      break;

    case UI_WIFI_OTA:
      if (id == BUTTON_CANCEL) {
        uiScreen =
          UI_SETTINGS;
      }
      break;

    case UI_TIMER_MENU:
      if (
        id ==
        BUTTON_UP
      ) {
        moveSelection(
          scheduleMenuIndex,
          TIMER_MENU_COUNT,
          -1
        );
      }

      if (
        id ==
        BUTTON_DOWN
      ) {
        moveSelection(
          scheduleMenuIndex,
          TIMER_MENU_COUNT,
          +1
        );
      }

      if (
        id ==
        BUTTON_CANCEL
      ) {
        uiScreen =
          UI_SETTINGS;
      }

      if (
        id ==
        BUTTON_OK
      ) {
        if (
          scheduleMenuIndex ==
          0
        ) {
          editTimerMode =
            timerMode;

          uiScreen =
            UI_TIMER_MODE;
        }
        else if (
          scheduleMenuIndex >=
            1 &&
          scheduleMenuIndex <=
            16
        ) {
          openScheduleEditor(
            scheduleMenuIndex -
            1
          );

          uiScreen =
            UI_SCHEDULE_EDIT;
        }
        else if (
          scheduleMenuIndex ==
          17
        ) {
          rtcReturnScreen =
            UI_TIMER_MENU;

          openRtcEditor();

          uiScreen =
            UI_RTC_EDIT;
        }
        else if (
          scheduleMenuIndex ==
          18
        ) {
          clearProgramConfirm =
            false;

          uiScreen =
            UI_CLEAR_PROGRAM;
        }
        else if (
          scheduleMenuIndex ==
          19
        ) {
          clearAllConfirm =
            false;

          uiScreen =
            UI_CLEAR_ALL;
        }
        else {
          uiScreen =
            UI_TIMER_STATUS;
        }
      }
      break;

    case UI_TIMER_MODE:
      if (
        id ==
        BUTTON_UP
      ) {
        int next =
          (int)editTimerMode -
          1;

        if (
          next <
          0
        ) {
          next =
            (int)TIMER_MODE_FORCE_OFF;
        }

        editTimerMode =
          (TimerMode)next;
      }

      if (
        id ==
        BUTTON_DOWN
      ) {
        int next =
          (int)editTimerMode +
          1;

        if (
          next >
          (int)TIMER_MODE_FORCE_OFF
        ) {
          next =
            (int)TIMER_MODE_AUTO;
        }

        editTimerMode =
          (TimerMode)next;
      }

      if (
        id ==
        BUTTON_CANCEL
      ) {
        editTimerMode =
          timerMode;

        uiScreen =
          UI_TIMER_MENU;
      }

      if (
        id ==
        BUTTON_OK
      ) {
        timerMode =
          editTimerMode;

        saveTimerModeNVS();


        uiScreen =
          UI_TIMER_MENU;
      }
      break;

    case UI_SCHEDULE_EDIT:
      if (
        scheduleValueEditing
      ) {
        if (
          id ==
          BUTTON_UP
        ) {
          changeScheduleValue(
            +1
          );
        }

        if (
          id ==
          BUTTON_DOWN
        ) {
          changeScheduleValue(
            -1
          );
        }

        if (
          id ==
            BUTTON_OK ||
          id ==
            BUTTON_CANCEL
        ) {
          scheduleValueEditing =
            false;
        }
      } else {
        if (
          id ==
          BUTTON_UP
        ) {
          moveSelection(
            scheduleEditField,
            7,
            -1
          );
        }

        if (
          id ==
          BUTTON_DOWN
        ) {
          moveSelection(
            scheduleEditField,
            7,
            +1
          );
        }

        if (
          id ==
          BUTTON_CANCEL
        ) {
          uiScreen =
            UI_TIMER_MENU;
        }

        if (
          id ==
          BUTTON_OK
        ) {
          if (
            scheduleEditField ==
            6
          ) {
            commitScheduleEditor();

            uiScreen =
              UI_TIMER_MENU;
          } else {
            scheduleValueEditing =
              true;
          }
        }
      }
      break;

    case UI_RTC_EDIT:
      if (
        rtcValueEditing
      ) {
        if (
          id ==
          BUTTON_UP
        ) {
          changeRtcValue(
            +1
          );
        }

        if (
          id ==
          BUTTON_DOWN
        ) {
          changeRtcValue(
            -1
          );
        }

        if (
          id ==
            BUTTON_OK ||
          id ==
            BUTTON_CANCEL
        ) {
          rtcValueEditing =
            false;
        }
      } else {
        if (
          id ==
          BUTTON_UP
        ) {
          moveSelection(
            rtcEditField,
            6,
            -1
          );
        }

        if (
          id ==
          BUTTON_DOWN
        ) {
          moveSelection(
            rtcEditField,
            6,
            +1
          );
        }

        if (
          id ==
          BUTTON_CANCEL
        ) {
          uiScreen =
            rtcReturnScreen;
        }

        if (
          id ==
          BUTTON_OK
        ) {
          if (
            rtcEditField ==
            5
          ) {
            if (
              saveRtcEditor()
            ) {
              uiScreen =
                UI_TIMER_MENU;
            }
          } else {
            rtcValueEditing =
              true;
          }
        }
      }
      break;

    case UI_CLEAR_PROGRAM:
      if (
        !clearProgramConfirm
      ) {
        if (
          id ==
          BUTTON_UP
        ) {
          moveSelection(
            clearProgramIndex,
            WEEKLY_SCHEDULE_COUNT,
            -1
          );
        }

        if (
          id ==
          BUTTON_DOWN
        ) {
          moveSelection(
            clearProgramIndex,
            WEEKLY_SCHEDULE_COUNT,
            +1
          );
        }

        if (
          id ==
          BUTTON_OK
        ) {
          clearProgramConfirm =
            true;
        }

        if (
          id ==
          BUTTON_CANCEL
        ) {
          uiScreen =
            UI_TIMER_MENU;
        }
      } else {
        if (
          id ==
          BUTTON_OK
        ) {
          clearProgram(
            clearProgramIndex
          );

          clearProgramConfirm =
            false;

          uiScreen =
            UI_TIMER_MENU;
        }

        if (
          id ==
          BUTTON_CANCEL
        ) {
          clearProgramConfirm =
            false;
        }
      }
      break;

    case UI_CLEAR_ALL:
      if (
        !clearAllConfirm
      ) {
        if (
          id ==
          BUTTON_OK
        ) {
          clearAllConfirm =
            true;
        }

        if (
          id ==
          BUTTON_CANCEL
        ) {
          uiScreen =
            UI_TIMER_MENU;
        }
      } else {
        if (
          id ==
          BUTTON_OK
        ) {
          clearAllPrograms();

          clearAllConfirm =
            false;

          uiScreen =
            UI_TIMER_MENU;
        }

        if (
          id ==
          BUTTON_CANCEL
        ) {
          clearAllConfirm =
            false;
        }
      }
      break;

    case UI_TIMER_STATUS:
      if (
        id ==
        BUTTON_CANCEL
      ) {
        uiScreen =
          UI_TIMER_MENU;
      }
      break;
  }

  // Jangan render LCD langsung dari handler tombol. Handler ini juga dapat
  // dipanggil saat firmware sedang menunggu Modbus/PZEM/NTP. Cukup tandai
  // dirty; serviceLCDRefresh() akan menggambar pada jalur utama dengan aman.
  lcdDirty = true;
}

void serviceOneButton(ButtonState &b, ButtonId id) {
  bool raw = buttonRawPressed(b);
  uint32_t now = millis();

  if (raw != b.lastRawPressed) {
    b.lastRawPressed = raw;
    b.rawChangedMs = now;
  }

  // Perubahan state yang sudah lolos debounce.
  if (
    raw != b.stablePressed &&
    (uint32_t)(now - b.rawChangedMs) >= BUTTON_DEBOUNCE_MS
  ) {
    b.stablePressed = raw;

    if (b.stablePressed) {
      b.pressedSinceMs = now;
      b.lastRepeatMs = now;

      // Setiap PRESS fisik berbunyi satu kali.
      // Non-blocking: tidak ada delay() untuk buzzer.
      beepButton();

      handleButton(id);
    } else {
      b.pressedSinceMs = 0;
      b.lastRepeatMs = 0;
    }

    return;
  }

  // Auto-repeat HANYA untuk UP dan DOWN.
  // OK/CANCEL sengaja one-shot agar tidak double-save / double-delete
  // ketika tombol tidak sengaja ditahan.
  if (
    b.stablePressed &&
    raw &&
    (
      id == BUTTON_UP ||
      id == BUTTON_DOWN
    )
  ) {
    uint32_t heldMs =
      (uint32_t)(now - b.pressedSinceMs);

    if (heldMs < BUTTON_HOLD_START_MS) {
      return;
    }

    uint32_t repeatMs = BUTTON_REPEAT_NORMAL_MS;

    if (heldMs >= BUTTON_TURBO_AFTER_MS) {
      repeatMs = BUTTON_REPEAT_TURBO_MS;
    } else if (heldMs >= BUTTON_FAST_AFTER_MS) {
      repeatMs = BUTTON_REPEAT_FAST_MS;
    }

    if (
      (uint32_t)(now - b.lastRepeatMs) >= repeatMs
    ) {
      b.lastRepeatMs = now;

      // Tidak beep pada setiap repeat supaya buzzer tidak "machine-gun".
      handleButton(id);
    }
  }
}

void serviceButtons() {
  serviceOneButton(btnCancel, BUTTON_CANCEL);
  serviceOneButton(btnOk, BUTTON_OK);
  serviceOneButton(btnUp, BUTTON_UP);
  serviceOneButton(btnDown, BUTTON_DOWN);
}

// =============================================================================
// RELAY / TCA9554
// =============================================================================
bool tcaWrite(uint8_t reg, uint8_t value) {
  Wire.beginTransmission(TCA9554_ADDR);
  Wire.write(reg);
  Wire.write(value);
  return Wire.endTransmission() == 0;
}

bool tcaRead(uint8_t reg, uint8_t &value) {
  Wire.beginTransmission(TCA9554_ADDR);
  Wire.write(reg);

  if (
    Wire.endTransmission(false) !=
    0
  ) {
    return false;
  }

  if (
    Wire.requestFrom(
      (int)TCA9554_ADDR,
      1
    ) !=
    1
  ) {
    return false;
  }

  value =
    Wire.read();

  return true;
}

bool setRelay(uint8_t channel, bool on) {
  if (!relayReady || channel < 1 || channel > 8) return false;

  uint8_t mask = (uint8_t)(1U << (channel - 1));
  uint8_t nextState = relayState;

  if (on) {
    nextState |= mask;
  } else {
    nextState &= (uint8_t)~mask;
  }

  if (
    !tcaWrite(
      TCA_OUTPUT_REG,
      nextState
    )
  ) {
    return false;
  }

  relayState =
    nextState;

  return true;
}

bool relayOutputReadback(
  uint8_t channel,
  bool &isActive
) {
  if (
    !relayReady ||
    channel < 1 ||
    channel > 8
  ) {
    return false;
  }

  uint8_t value = 0;

  if (
    !tcaRead(
      TCA_OUTPUT_REG,
      value
    )
  ) {
    return false;
  }

  relayState =
    value;

  uint8_t mask =
    (uint8_t)(
      1U <<
      (channel - 1)
    );

  isActive =
    (value & mask) !=
    0;

  return true;
}

bool setPumpOutput(
  uint8_t channel,
  bool requestedActive,
  bool &actualActive
) {
  // Blokir ON selama penghentian belum terverifikasi.
  // OFF tetap diizinkan.
  if (requestedActive && (spffShutdownPending || spffShutdownFaultLatched)) {
    return false;
  }

  if (
    !setRelay(
      channel,
      requestedActive
    )
  ) {
    return false;
  }

  // Beri waktu singkat untuk output expander berubah.
  // Gunakan delay biasa agar command handler tidak re-enter ke parser serial.
  delay(60);

  if (
    !relayOutputReadback(
      channel,
      actualActive
    )
  ) {
    return false;
  }

  return
    actualActive ==
    requestedActive;
}

// =============================================================================
// WEEKLY TIMER -> RELAY PENYIRAMAN CH3
// =============================================================================
// Timer software hanya mengendalikan PUMP_WATER_RELAY, yang pada wiring fisik
// adalah CH3. Pompa nutrisi CH1 tidak disentuh oleh fungsi ini.
//
// Prioritas pada mode timer:
// - OTOMATIS          : CH3 mengikuti jadwal mingguan.
// - PAKSA AKTIF       : CH3 ON terus.
// - PAKSA NONAKTIF    : CH3 OFF terus.
//
// Pada build legacy fungsi ini menulis CH3 terus-menerus. Build server-control
// menonaktifkan writer tersebut agar command manual dan schedule Orange Pi
// menjadi satu-satunya sumber perubahan output pompa.
void serviceIrrigationTimerOutput() {
  // Backend server mengevaluasi jadwal dan mengirim set_pump untuk ON/OFF.
  // Guard ini mencegah timer lokal membatalkan command remote pump_water.
  if (SPFF_DISABLE_LEGACY_LOCAL_TIMER) {
    serviceSpffSyncedScheduleOutput();
    return;
  }

  if (!relayReady) {
    return;
  }

  const bool requestedActive = timerOutputActive();
  const uint8_t mask =
    (uint8_t)(1U << (PUMP_WATER_RELAY - 1));

  const bool currentActive =
    (relayState & mask) != 0;

  // Hindari write I2C berulang jika state sudah sesuai.
  if (currentActive == requestedActive) {
    return;
  }

  bool actualActive = false;
  const bool ok = setPumpOutput(
    PUMP_WATER_RELAY,
    requestedActive,
    actualActive
  );

  if (ok) {
  } else {
  }
}

// SHT20 sekarang terhubung langsung ke bus RS485.
// Fungsi ini dipertahankan sebagai NO-OP agar alur polling sensor lama
// tidak perlu diubah besar-besaran.
void initRelay() {
  relayReady =
    i2cExists(
      TCA9554_ADDR
    );

  if (!relayReady) {
    return;
  }

  // Fail-safe boot: semua relay OFF.
  relayState = 0;

  bool ok =
    tcaWrite(
      TCA_OUTPUT_REG,
      relayState
    );

  ok =
    tcaWrite(
      TCA_POLARITY_REG,
      0x00
    ) &&
    ok;

  ok =
    tcaWrite(
      TCA_CONFIG_REG,
      0x00
    ) &&
    ok;

  if (!ok) {
    relayReady = false;


    return;
  }

}

// =============================================================================
// MODBUS CORE
// =============================================================================
uint16_t modbusCRC(const uint8_t *data, size_t len) {
  uint16_t crc = 0xFFFF;

  for (size_t i = 0; i < len; i++) {
    crc ^= data[i];

    for (uint8_t bit = 0; bit < 8; bit++) {
      if (crc & 1) crc = (crc >> 1) ^ 0xA001;
      else crc >>= 1;
    }
  }

  return crc;
}

bool validCRC(const uint8_t *frame, size_t len) {
  if (len < 4) return false;

  uint16_t expected =
    (uint16_t)frame[len - 2] |
    ((uint16_t)frame[len - 1] << 8);

  return modbusCRC(frame, len - 2) == expected;
}

void clearBus() {
  while (RS485.available()) RS485.read();
}

void setBusBaud(uint32_t baud, bool force = false) {
  if (!force && activeBaud == baud) {
    clearBus();
    return;
  }

  RS485.end();
  delay(50);

  RS485.begin(
    baud,
    SERIAL_8N1,
    RS485_RX_PIN,
    RS485_TX_PIN,
    false
  );

  activeBaud = baud;

  uiDelay(180);
  clearBus();
}

size_t modbusReadRaw(
  uint32_t baud,
  uint8_t id,
  uint8_t functionCode,
  uint16_t startReg,
  uint16_t count,
  uint8_t *rx,
  size_t rxCapacity,
  uint32_t timeoutMs
) {
  setBusBaud(baud);

  uint8_t request[8] = {
    id,
    functionCode,
    highByte(startReg),
    lowByte(startReg),
    highByte(count),
    lowByte(count),
    0,
    0
  };

  uint16_t crc = modbusCRC(request, 6);
  request[6] = lowByte(crc);
  request[7] = highByte(crc);

  clearBus();
  uiDelay(35);

  RS485.write(request, sizeof(request));
  RS485.flush();

  size_t rxLen = 0;
  bool gotAny = false;
  uint32_t started = millis();
  uint32_t lastByte = started;

  while ((uint32_t)(millis() - started) < timeoutMs) {
    while (RS485.available()) {
      uint8_t b = (uint8_t)RS485.read();

      if (rxLen < rxCapacity) {
        rx[rxLen++] = b;
      }

      gotAny = true;
      lastByte = millis();
    }

    if (gotAny && (uint32_t)(millis() - lastByte) >= 45UL) {
      break;
    }

    serviceSpffGatewaySerial();
    serviceDeviceStatus();
    serviceBuzzer();
    serviceButtons();
    serviceLCDRefresh();
    delay(1);
  }

  return rxLen;
}

bool extractRegisters(
  const uint8_t *rx,
  size_t rxLen,
  uint8_t id,
  uint8_t functionCode,
  uint16_t *regs,
  uint16_t count
) {
  uint8_t byteCount = (uint8_t)(count * 2);
  size_t frameLen = 3 + byteCount + 2;

  for (size_t start = 0; start + frameLen <= rxLen; start++) {
    const uint8_t *frame = &rx[start];

    if (frame[0] != id) continue;
    if (frame[1] != functionCode) continue;
    if (frame[2] != byteCount) continue;
    if (!validCRC(frame, frameLen)) continue;

    for (uint16_t i = 0; i < count; i++) {
      regs[i] =
        ((uint16_t)frame[3 + i * 2] << 8) |
        frame[4 + i * 2];
    }

    return true;
  }

  return false;
}

// =============================================================================
// NUTRISENSE
// =============================================================================
bool parseNutri(const uint8_t *rx, size_t rxLen) {
  uint16_t reg[3];

  if (!extractRegisters(rx, rxLen, NUTRI_ID, 0x03, reg, 3)) {
    return false;
  }

  float rawPh = reg[0] / 100.0f;
  float rawEc = (float)reg[1];
  float rawTemp = ((int16_t)reg[2]) / 10.0f;

  // Reject frame aneh yang pernah muncul T=0.0 C.
  // Plausibility dicek pada data RAW agar setting kalibrasi tidak
  // menyamarkan frame Modbus yang memang rusak.
  if (rawPh < 0.0f || rawPh > 14.0f) return false;
  if (reg[2] == 0) return false;
  if (rawTemp < -10.0f || rawTemp > 80.0f) return false;

  float ph = rawPh * NUTRI_PH_GAIN + NUTRI_PH_OFFSET;
  float ec = rawEc * NUTRI_EC_GAIN + NUTRI_EC_OFFSET;
  float temp = rawTemp * NUTRI_TEMP_GAIN + NUTRI_TEMP_OFFSET;

  nutri.ph = ph;
  nutri.ec = ec;
  nutri.temp = temp;
  nutri.hasValue = true;
  nutri.fresh = true;
  nutri.lastGoodMs = millis();

  return true;
}

bool nutriCacheUsable() {
  if (!nutri.hasValue || nutri.lastGoodMs == 0) return false;

  return
    (uint32_t)(millis() - nutri.lastGoodMs) <=
    NUTRI_CACHE_MAX_AGE_MS;
}

const char* nutriStateText() {
  return nutriCycleOk ? "OK" : "NO";
}

bool readNutri() {
  nutriCycleOk = false;
  nutri.fresh = false;

  // Hard re-open sebelum perangkat 9600 pertama. Setelah Soil berjalan di
  // 4850 baud, beberapa slave 9600 terbukti lebih stabil jika UART benar-
  // benar di-reset dan bus diberi quiet time sebelum request pertama.
  setBusBaud(BAUD_9600, true);
  uiDelay(220);
  clearBus();

  for (uint8_t attempt = 1; attempt <= 4; attempt++) {
    uint8_t rx[48];

    size_t len = modbusReadRaw(
      BAUD_9600, NUTRI_ID, 0x03, 0, 3,
      rx, sizeof(rx), 450UL
    );

    if (len > 0 && parseNutri(rx, len)) {
      nutriCycleOk = true;


      return true;
    }

    uiDelay(70);
  }

  // Satu recovery UART jika empat request awal tidak lolos.
  setBusBaud(BAUD_9600, true);
  uiDelay(250);

  for (uint8_t attempt = 1; attempt <= 2; attempt++) {
    uint8_t rx[48];

    size_t len = modbusReadRaw(
      BAUD_9600, NUTRI_ID, 0x03, 0, 3,
      rx, sizeof(rx), 450UL
    );

    if (len > 0 && parseNutri(rx, len)) {
      nutriCycleOk = true;


      return true;
    }

    uiDelay(80);
  }

  if (nutriCacheUsable()) {
    nutriCycleOk = true;

    return true;
  }

  return false;
}

// =============================================================================
// SHT20 RS485
// =============================================================================
// SHT20 memakai Modbus RTU langsung: ID3, 9600 8N1, FC04, register
// 0x0001 (temperature) dan 0x0002 (humidity). Current read tetap menentukan
// health cycle. Last-valid boleh dibawa telemetry snapshot maksimal 300 detik / 5 menit.

void initSHT20() {
  sht.temp = NAN;
  sht.rh = NAN;
  sht.hasValue = false;
  sht.fresh = false;
  sht.lastGoodMs = 0;
  shtCycleOk = false;

  setBusBaud(BAUD_9600, true);
  clearBus();
}

bool shtTelemetryValid() {
  return
    shtCycleOk &&
    sht.hasValue &&
    sht.fresh &&
    isfinite(sht.temp) &&
    isfinite(sht.rh) &&
    sht.temp >= -20.0f &&
    sht.temp <= 80.0f &&
    sht.rh >= 0.0f &&
    sht.rh <= 100.0f;
}

void logSHT20Failure(
  const char *reason,
  size_t rxLength
) {
  // GPIO43/GPIO44 dipakai dedicated untuk PZEM. USB Serial tetap native USB
  // dan wajib JSON Lines murni, jadi human-readable debug tidak dikirim ke Serial.
  // Detail failure dipertahankan melalui sensorHealth ("read_error").
  (void)reason;
  (void)rxLength;
}

const char* shtStateText() {
  return shtTelemetryValid() ? "OK" : "NO";
}

bool applySHT20Registers(uint16_t tempReg, uint16_t rhReg) {
  const float temp = static_cast<int16_t>(tempReg) / 10.0f;
  const float rh = rhReg / 10.0f;

  if (
    !isfinite(temp) ||
    !isfinite(rh) ||
    temp < -20.0f ||
    temp > 80.0f ||
    rh < 0.0f ||
    rh > 100.0f
  ) {
    return false;
  }

  sht.temp = temp;
  sht.rh = rh;
  sht.hasValue = true;
  sht.fresh = true;
  sht.lastGoodMs = millis();
  shtCycleOk = true;
  return true;
}

bool readSHT20SingleRegister(uint16_t startReg, uint16_t &value) {
  for (uint8_t attempt = 1; attempt <= SHT20_SPLIT_READ_ATTEMPTS; attempt++) {
    uint8_t rx[24] = {0};
    uint16_t reg[1] = {0};

    clearBus();
    uiDelay(SHT20_PRE_REQUEST_QUIET_MS);

    const size_t len = modbusReadRaw(
      BAUD_9600,
      SHT20_ID,
      0x04,
      startReg,
      1,
      rx,
      sizeof(rx),
      SHT20_RESPONSE_TIMEOUT_MS
    );

    if (
      len > 0 &&
      extractRegisters(rx, len, SHT20_ID, 0x04, reg, 1)
    ) {
      value = reg[0];
      return true;
    }

    if (attempt < SHT20_SPLIT_READ_ATTEMPTS) {
      setBusBaud(BAUD_9600, true);
      uiDelay(220);
      clearBus();
    }
  }

  return false;
}

bool readSHT20() {
  shtCycleOk = false;
  sht.fresh = false;

  // SHT20 adalah device 9600 yang paling sensitif pada shared RS485. Mulai
  // setiap cycle dari UART yang benar-benar di-reopen dan bus yang tenang.
  setBusBaud(BAUD_9600, true);
  uiDelay(260);
  clearBus();

  const char *failureReason = "no_response";
  size_t lastRxLength = 0;

  // Jalur utama: baca temperature + humidity sekaligus (FC04 R1..R2).
  for (uint8_t attempt = 1; attempt <= SHT20_READ_ATTEMPTS; attempt++) {
    if (
      attempt ==
      (uint8_t)(SHT20_FORCE_REOPEN_AFTER_ATTEMPT + 1U)
    ) {
      setBusBaud(BAUD_9600, true);
      uiDelay(260);
      clearBus();
    }

    uint8_t rx[32] = {0};
    uint16_t reg[2] = {0, 0};

    clearBus();
    uiDelay(SHT20_PRE_REQUEST_QUIET_MS);

    const size_t len = modbusReadRaw(
      BAUD_9600,
      SHT20_ID,
      0x04,
      0x0001,
      2,
      rx,
      sizeof(rx),
      SHT20_RESPONSE_TIMEOUT_MS
    );

    lastRxLength = len;

    if (len == 0) {
      failureReason = "no_response";
    } else if (
      !extractRegisters(rx, len, SHT20_ID, 0x04, reg, 2)
    ) {
      failureReason = "invalid_modbus_frame_or_crc";
    } else if (applySHT20Registers(reg[0], reg[1])) {
      return true;
    } else {
      failureReason = "value_out_of_range";
    }

    clearBus();
    if (attempt < SHT20_READ_ATTEMPTS) {
      uiDelay(SHT20_RETRY_GAP_MS);
    }
  }

  // Fallback: beberapa modul SHT20/RS485 lebih stabil bila register dibaca
  // satu-per-satu. Tetap memakai contract yang sama: FC04, R1=temp, R2=RH.
  setBusBaud(BAUD_9600, true);
  uiDelay(300);
  clearBus();

  uint16_t tempReg = 0;
  uint16_t rhReg = 0;
  const bool tempOk = readSHT20SingleRegister(0x0001, tempReg);

  if (tempOk) {
    uiDelay(220);
    clearBus();
  }

  const bool rhOk = tempOk && readSHT20SingleRegister(0x0002, rhReg);

  if (tempOk && rhOk && applySHT20Registers(tempReg, rhReg)) {
    return true;
  }

  if (tempOk && !rhOk) {
    failureReason = "humidity_no_response";
  } else if (!tempOk) {
    failureReason = "temperature_no_response";
  } else {
    failureReason = "split_value_out_of_range";
  }

  sht.fresh = false;
  shtCycleOk = false;
  logSHT20Failure(failureReason, lastRxLength);
  return false;
}


// =============================================================================
// PZEM-004T v3 - DEDICATED TTL UART GPIO44/GPIO43
// =============================================================================
// Protocol: Modbus RTU, 9600 8N1, FC04, input registers 0x0000..0x0009.
// Dedicated UART prevents PZEM traffic from disturbing the shared RS485 bus.
void clearPzemSerial() {
  while (PZEMSerial.available()) {
    (void)PZEMSerial.read();
  }
}

bool parsePzemResponse(
  const uint8_t *rx,
  size_t rxLen,
  uint8_t requestAddress,
  PzemData &parsed
) {
  static constexpr uint8_t REGISTER_COUNT = 10;
  static constexpr uint8_t BYTE_COUNT = REGISTER_COUNT * 2;
  static constexpr size_t FRAME_LEN = 3U + BYTE_COUNT + 2U;

  for (
    size_t start = 0;
    start + FRAME_LEN <= rxLen;
    start++
  ) {
    const uint8_t *frame = &rx[start];

    const bool addressOk =
      frame[0] == requestAddress ||
      (
        requestAddress == PZEM_GENERAL_ADDRESS &&
        frame[0] == PZEM_DEFAULT_ADDRESS
      );

    if (!addressOk) continue;
    if (frame[1] != 0x04) continue;
    if (frame[2] != BYTE_COUNT) continue;
    if (!validCRC(frame, FRAME_LEN)) continue;

    uint16_t reg[REGISTER_COUNT] = {0};

    for (uint8_t i = 0; i < REGISTER_COUNT; i++) {
      reg[i] =
        ((uint16_t)frame[3U + i * 2U] << 8) |
        frame[4U + i * 2U];
    }

    const uint32_t currentRaw =
      ((uint32_t)reg[2] << 16) |
      reg[1];

    const uint32_t powerRaw =
      ((uint32_t)reg[4] << 16) |
      reg[3];

    const uint32_t energyWh =
      ((uint32_t)reg[6] << 16) |
      reg[5];

    const float voltageV =
      reg[0] / 10.0f;

    const float currentA =
      currentRaw / 1000.0f;

    const float powerW =
      powerRaw / 10.0f;

    const float energyKwh =
      energyWh / 1000.0f;

    const float frequencyHz =
      reg[7] / 10.0f;

    const float powerFactor =
      reg[8] / 100.0f;

    // Plausibility is intentionally broad. Zero current/power/PF is valid
    // when the measured load is off.
    if (
      !isfinite(voltageV) ||
      !isfinite(currentA) ||
      !isfinite(powerW) ||
      !isfinite(energyKwh) ||
      !isfinite(frequencyHz) ||
      !isfinite(powerFactor) ||
      voltageV < 0.0f ||
      voltageV > 300.0f ||
      currentA < 0.0f ||
      currentA > 150.0f ||
      powerW < 0.0f ||
      powerW > 40000.0f ||
      energyKwh < 0.0f ||
      frequencyHz < 0.0f ||
      frequencyHz > 100.0f ||
      powerFactor < 0.0f ||
      powerFactor > 1.10f
    ) {
      return false;
    }

    parsed.voltageV = voltageV;
    parsed.currentA = currentA;
    parsed.powerW = powerW;
    parsed.energyKwh = energyKwh;
    parsed.frequencyHz = frequencyHz;
    parsed.powerFactor = powerFactor;
    parsed.hasValue = true;
    parsed.fresh = true;
    parsed.lastGoodMs = millis();
    parsed.respondingAddress = frame[0];

    return true;
  }

  return false;
}

bool readPzemAddress(
  uint8_t address,
  PzemData &parsed
) {
  uint8_t request[8] = {
    address,
    0x04,
    0x00,
    0x00,
    0x00,
    0x0A,
    0,
    0
  };

  const uint16_t crc =
    modbusCRC(
      request,
      6
    );

  request[6] = lowByte(crc);
  request[7] = highByte(crc);

  clearPzemSerial();
  uiDelay(15);

  PZEMSerial.write(
    request,
    sizeof(request)
  );

  PZEMSerial.flush();

  // Buffer dibuat lebih besar agar request echo + response PZEM tetap bisa
  // ditangkap dalam satu transaction.
  uint8_t rx[64] = {0};
  size_t rxLen = 0;
  uint32_t started = millis();

  while (
    (uint32_t)(millis() - started) <
    PZEM_RESPONSE_TIMEOUT_MS
  ) {
    while (PZEMSerial.available()) {
      const uint8_t b =
        (uint8_t)PZEMSerial.read();

      if (rxLen < sizeof(rx)) {
        rx[rxLen++] = b;
      }
    }

    // Parse terus selama timeout. Jika 8 byte yang diterima hanya request echo,
    // parser memang belum valid dan kita tetap menunggu response 25-byte.
    if (
      rxLen >= 25U &&
      parsePzemResponse(
        rx,
        rxLen,
        address,
        parsed
      )
    ) {
      return true;
    }

    serviceSpffGatewaySerial();
    serviceDeviceStatus();
    serviceBuzzer();
    serviceButtons();
    serviceLCDRefresh();
    delay(1);
  }

  if (rxLen == 0) {
    return false;
  }

  return parsePzemResponse(
    rx,
    rxLen,
    address,
    parsed
  );
}

bool readPzem() {
  pzem.lastAttemptMs = millis();
  pzem.fresh = false;

  // Global address 0xF8 is convenient for a single dedicated meter.
  // Fallback to default slave address 0x01 for units that do not answer 0xF8.
  PzemData parsed = pzem;

  if (
    !readPzemAddress(
      PZEM_GENERAL_ADDRESS,
      parsed
    )
  ) {
    clearPzemSerial();
    uiDelay(40);

    if (
      !readPzemAddress(
        PZEM_DEFAULT_ADDRESS,
        parsed
      )
    ) {
      return false;
    }
  }

  pzem = parsed;
  return true;
}

bool pzemHealthValid() {
  return
    pzem.hasValue &&
    pzem.lastGoodMs != 0 &&
    (uint32_t)(millis() - pzem.lastGoodMs) <=
      PZEM_HEALTH_MAX_AGE_MS;
}

void servicePzem() {
  const uint32_t now = millis();

  if (
    pzem.lastAttemptMs != 0 &&
    (uint32_t)(now - pzem.lastAttemptMs) <
      PZEM_READ_INTERVAL_MS
  ) {
    return;
  }

  (void)readPzem();
}



// =============================================================================
// SLAVE ID 5
// =============================================================================
bool applySlaveRegs(const uint16_t *reg, uint8_t count) {
  if (count < 4) return false;

  slaveData.waterDistanceValid = reg[0] != 0xFFFF;
  slaveData.fertDistanceValid = reg[1] != 0xFFFF;

  slaveData.waterDistanceCm =
    slaveData.waterDistanceValid ? reg[0] / 10.0f : NAN;

  slaveData.fertDistanceCm =
    slaveData.fertDistanceValid ? reg[1] / 10.0f : NAN;

  slaveData.waterFlowLpm = reg[2] / 100.0f;
  slaveData.fertFlowLpm = reg[3] / 100.0f;

  slaveData.totalsAvailable = count >= 8;

  if (slaveData.totalsAvailable) {
    slaveData.waterTotalMl =
      ((uint32_t)reg[4] << 16) | reg[5];

    slaveData.fertTotalMl =
      ((uint32_t)reg[6] << 16) | reg[7];
  }

  slaveData.hasValue = true;
  slaveData.fresh = true;
  slaveData.lastGoodMs = millis();

  return true;
}

bool trySlaveRead(uint8_t count, uint8_t attempts) {
  for (uint8_t attempt = 1; attempt <= attempts; attempt++) {
    uint8_t rx[64];
    uint16_t reg[8] = {0};

    size_t len = modbusReadRaw(
      BAUD_9600, SLAVE_ID, 0x03, 0, count,
      rx, sizeof(rx), 700UL
    );

    if (
      len > 0 &&
      extractRegisters(rx, len, SLAVE_ID, 0x03, reg, count) &&
      applySlaveRegs(reg, count)
    ) {
      return true;
    }

    uiDelay(80);
  }

  return false;
}

String distanceText(bool valid, float value) {
  return valid ? String(value, 1) + "cm" : "NO-ECHO";
}

bool slaveCacheUsable() {
  if (!slaveData.hasValue || slaveData.lastGoodMs == 0) {
    return false;
  }

  return
    (uint32_t)(millis() - slaveData.lastGoodMs) <=
    SLAVE_CACHE_MAX_AGE_MS;
}

const char* slaveStateText() {
  return slaveCycleOk ? "OK" : "NO";
}

bool readSlave() {
  slaveCycleOk = false;
  slaveData.fresh = false;

  // Slave ID5 berbagi bus 9600 dengan Nutrisense dan SHT20. Re-open UART
  // untuk membuang framing state/byte sisa dari transaksi sebelumnya.
  setBusBaud(BAUD_9600, true);
  uiDelay(320);
  clearBus();

  // ID5 membawa JSN + flow. Beri timeout lebih longgar karena slave juga
  // melayani state-machine ultrasonic dan interrupt flow secara bersamaan.
  bool ok = trySlaveRead(8, 3);

  // Fallback kompatibel dengan firmware lama HR0..HR3.
  if (!ok) {
    ok = trySlaveRead(4, 2);
  }

  // Re-open UART sekali jika frame masih gagal.
  if (!ok) {
    setBusBaud(BAUD_9600, true);
    uiDelay(100);
    ok = trySlaveRead(8, 3);
  }

  if (ok) {
    slaveCycleOk = true;
    return true;
  }

  // Satu timeout tidak perlu membuat log/status terlihat error besar.
  // Nilai tetap last-good dan hanya dipakai sampai 60 detik.
  if (slaveCacheUsable()) {
    slaveCycleOk = true;
    return true;
  }

  return false;
}

// =============================================================================
// SOIL 7-IN-1 - PRIORITY CACHE + SENSOR HEALTH
// =============================================================================
//
// - Prioritas register yang belum pernah berhasil dibaca.
// - Setelah lengkap, refresh register dengan umur last-good paling tua.
// - 2 target per Soil per cycle.
// - Missing register max 5 retry.
// - Maintenance register max 3 retry.
// - Freshness per field untuk health/polling tetap 60 detik.
// - Snapshot telemetry dapat membawa last-valid field maksimal 300 detik / 5 menit.
// - Baud tetap 4850.
//
bool soilPlausible(uint8_t reg, uint16_t raw) {
  switch (reg) {
    case 0:
      return raw <= 1000;

    case 1: {
      int16_t t = (int16_t)raw;
      return t >= -200 && t <= 700;
    }

    case 2:
      return raw <= 20000;

    case 3:
      return raw <= 140;

    case 4:
    case 5:
    case 6:
      return raw <= 5000;
  }

  return false;
}

uint32_t *soilRegTimeArray(uint8_t number) {
  return number == 1
    ? soil1RegLastGoodMs
    : soil2RegLastGoodMs;
}

uint8_t &soilAcquireCursor(uint8_t number) {
  return number == 1
    ? soil1AcquireCursor
    : soil2AcquireCursor;
}

bool readSoilSingleRegister(
  uint8_t sensorId,
  uint8_t reg,
  uint16_t &value,
  uint8_t attempts
) {
  for (uint8_t attempt = 1; attempt <= attempts; attempt++) {
    uint8_t rx[24];
    uint16_t tmp[1] = {0};

    size_t len = modbusReadRaw(
      SOIL_FIXED_BAUD,
      sensorId,
      0x03,
      reg,
      1,
      rx,
      sizeof(rx),
      SOIL_SINGLE_TIMEOUT_MS
    );

    if (
      len > 0 &&
      extractRegisters(
        rx,
        len,
        sensorId,
        0x03,
        tmp,
        1
      ) &&
      soilPlausible(reg, tmp[0])
    ) {
      value = tmp[0];
      return true;
    }

    clearBus();

    if (attempt < attempts) {
      uiDelay(45);
    }
  }

  return false;
}

uint8_t countFreshSoil(const SoilData &soil) {
  uint8_t count = 0;

  for (uint8_t reg = 0; reg < SOIL_REG_COUNT; reg++) {
    if (soil.freshField[reg]) {
      count++;
    }
  }

  return count;
}

uint8_t countSoilHave(const SoilData &soil) {
  uint8_t count = 0;

  for (uint8_t reg = 0; reg < SOIL_REG_COUNT; reg++) {
    if (soil.has[reg]) {
      count++;
    }
  }

  return count;
}

bool allSoilHaveData(const SoilData &soil) {
  return countSoilHave(soil) == SOIL_REG_COUNT;
}

String staleSoilRegs(const SoilData &soil) {
  String s;

  for (uint8_t reg = 0; reg < SOIL_REG_COUNT; reg++) {
    if (!soil.freshField[reg]) {
      if (s.length()) s += ",";
      s += "R";
      s += reg;
    }
  }

  return s;
}

void refreshSoilFreshFlags(
  uint8_t number,
  SoilData &soil
) {
  uint32_t now = millis();
  uint32_t *last = soilRegTimeArray(number);

  for (uint8_t reg = 0; reg < SOIL_REG_COUNT; reg++) {
    if (!soil.has[reg] || last[reg] == 0) {
      soil.freshField[reg] = false;
      continue;
    }

    soil.freshField[reg] =
      (uint32_t)(now - last[reg]) <=
      SOIL_FIELD_MAX_AGE_MS;
  }

  soil.complete = allSoilHaveData(soil);
  soil.fresh =
    soil.complete &&
    countFreshSoil(soil) == SOIL_REG_COUNT;
}

bool registerAlreadyChosen(
  uint8_t reg,
  const uint8_t chosen[SOIL_REGS_PER_CYCLE],
  uint8_t chosenCount
) {
  for (uint8_t i = 0; i < chosenCount; i++) {
    if (chosen[i] == reg) {
      return true;
    }
  }

  return false;
}

bool chooseMissingRegister(
  uint8_t number,
  const SoilData &soil,
  const uint8_t chosen[SOIL_REGS_PER_CYCLE],
  uint8_t chosenCount,
  uint8_t &regOut
) {
  uint8_t &cursor = soilAcquireCursor(number);

  for (uint8_t step = 0; step < SOIL_REG_COUNT; step++) {
    uint8_t reg =
      (uint8_t)((cursor + step) % SOIL_REG_COUNT);

    if (
      !soil.has[reg] &&
      !registerAlreadyChosen(reg, chosen, chosenCount)
    ) {
      regOut = reg;
      cursor =
        (uint8_t)((reg + 1) % SOIL_REG_COUNT);
      return true;
    }
  }

  return false;
}

bool chooseOldestRegister(
  uint8_t number,
  const SoilData &soil,
  const uint8_t chosen[SOIL_REGS_PER_CYCLE],
  uint8_t chosenCount,
  uint8_t &regOut
) {
  uint32_t *last = soilRegTimeArray(number);
  uint32_t now = millis();

  bool found = false;
  uint32_t bestAge = 0;

  for (uint8_t reg = 0; reg < SOIL_REG_COUNT; reg++) {
    if (!soil.has[reg]) continue;
    if (registerAlreadyChosen(reg, chosen, chosenCount)) continue;

    uint32_t age =
      last[reg] == 0
      ? 0xFFFFFFFFUL
      : (uint32_t)(now - last[reg]);

    if (!found || age > bestAge) {
      found = true;
      bestAge = age;
      regOut = reg;
    }
  }

  return found;
}

uint8_t buildSoilTargetList(
  uint8_t number,
  const SoilData &soil,
  uint8_t target[SOIL_REGS_PER_CYCLE]
) {
  uint8_t count = 0;

  while (count < SOIL_REGS_PER_CYCLE) {
    uint8_t reg = 0;

    if (
      !chooseMissingRegister(
        number,
        soil,
        target,
        count,
        reg
      )
    ) {
      break;
    }

    target[count++] = reg;
  }

  while (count < SOIL_REGS_PER_CYCLE) {
    uint8_t reg = 0;

    if (
      !chooseOldestRegister(
        number,
        soil,
        target,
        count,
        reg
      )
    ) {
      break;
    }

    target[count++] = reg;
  }

  return count;
}

bool readSoil(uint8_t number, uint8_t sensorId, SoilData &soil) {

  setBusBaud(SOIL_FIXED_BAUD);
  uiDelay(80);
  clearBus();

  uint32_t *last =
    soilRegTimeArray(number);

  uint8_t target[SOIL_REGS_PER_CYCLE] = {0};
  uint8_t targetCount =
    buildSoilTargetList(
      number,
      soil,
      target
    );

  bool anySuccessThisCycle = false;

  for (uint8_t slot = 0; slot < targetCount; slot++) {
    uint8_t reg = target[slot];

    bool acquiring =
      !soil.has[reg];

    uint8_t attempts =
      acquiring
      ? SOIL_ACQUIRE_RETRY
      : SOIL_MAINTENANCE_RETRY;

    uint16_t value = 0;

    if (
      readSoilSingleRegister(
        sensorId,
        reg,
        value,
        attempts
      )
    ) {
      soil.raw[reg] = value;
      soil.has[reg] = true;
      soil.regBaud[reg] = SOIL_FIXED_BAUD;
      last[reg] = millis();
      soil.lastGoodMs = millis();
      anySuccessThisCycle = true;
    }
  }

  soil.fallbackBaud = SOIL_FIXED_BAUD;

  refreshSoilFreshFlags(number, soil);

  bool sensorAlive =
    soil.lastGoodMs != 0 &&
    (uint32_t)(millis() - soil.lastGoodMs) <=
    SOIL_SENSOR_MAX_SILENCE_MS;

  if (!soil.complete) {

    return false;
  }

  if (anySuccessThisCycle || sensorAlive) {

    return true;
  }

  return false;
}

// =============================================================================
// LCD
// =============================================================================
void initLCD() {
  if (i2cExists(0x27)) lcd = &lcd27;
  else if (i2cExists(0x3F)) lcd = &lcd3F;
  else {
    return;
  }

  lcd->init();
  lcd->backlight();
  lcd->clear();

  lcdReady = true;
}

void lcdLine(uint8_t row, String text) {
  if (!lcdReady) return;

  if (text.length() > 20) text = text.substring(0, 20);
  while (text.length() < 20) text += ' ';

  lcd->setCursor(0, row);
  lcd->print(text);
}

String valueOrDash(float value, uint8_t decimals, bool valid) {
  if (!valid || isnan(value)) return "--";
  return String(value, (unsigned int)decimals);
}

String soilStateText(const SoilData &soil) {
  if (!soil.complete) return "NO";

  if (
    soil.lastGoodMs != 0 &&
    (uint32_t)(millis() - soil.lastGoodMs) <=
    SOIL_SENSOR_MAX_SILENCE_MS
  ) {
    return "OK";
  }

  return "HOLD";
}

// =============================================================================
// HUMAN-READABLE SERIAL MONITOR
// =============================================================================
// Fungsi ini hanya MEMBACA nilai yang sudah dihitung oleh program utama.
// Tidak melakukan polling tambahan dan tidak mengubah state sensor/aktuator.

// =============================================================================
// COMPACT SERIAL MONITOR
// =============================================================================
// Satu baris per cycle agar mudah dibaca saat commissioning.
// Hanya membaca state yang sudah ada; TIDAK melakukan polling tambahan.
// =============================================================================
// ARDUINO SERIAL PLOTTER
// =============================================================================
// Hanya membaca nilai yang SUDAH diperoleh oleh polling program utama.
// Tidak melakukan transaksi RS485 tambahan dan tidak mengubah data sensor.
//
// Catatan scaling grafik:
// - EC dibagi 100 agar pH/suhu/moisture tetap terlihat pada plot yang sama.
// - N/P/K dibagi 10 untuk alasan visual yang sama.
// - Nilai asli di struct/program utama TIDAK diubah.
void renderMenu(const char **items, uint8_t count, uint8_t selected) {
  lcdLine(0, rtcHeader());

  uint8_t first = 0;
  if (selected >= 3) first = selected - 2;

  for (uint8_t row = 1; row <= 3; row++) {
    uint8_t index = first + row - 1;

    if (index < count) {
      lcdLine(row, String(index == selected ? ">" : " ") + items[index]);
    } else {
      lcdLine(row, "");
    }
  }
}

void renderMonitor() {
  // Monitoring seluruh sistem sensor dengan navigasi manual.
  // UP/DOWN mengganti halaman, CANCEL kembali ke menu utama.
  const uint8_t page =
    monitorPageIndex;

  lcdLine(
    0,
    rtcHeader()
  );

  switch (page) {
    case 0:
      lcdLine(1, "NUTRISI");
      lcdLine(
        2,
        "pH:" +
        valueOrDash(nutri.ph, 2, nutri.hasValue) +
        " EC:" +
        valueOrDash(nutri.ec, 0, nutri.hasValue)
      );
      lcdLine(
        3,
        "T:" +
        valueOrDash(nutri.temp, 1, nutri.hasValue) +
        "C " +
        nutriStateText()
      );
      break;

    case 1:
      lcdLine(1, "UDARA SHT20");
      lcdLine(
        2,
        "T:" +
        valueOrDash(sht.temp, 1, sht.hasValue) +
        "C RH:" +
        valueOrDash(sht.rh, 1, sht.hasValue) +
        "%"
      );
      lcdLine(
        3,
        String("Status: ") +
        shtStateText()
      );
      break;

    case 2:
      lcdLine(
        1,
        String("PZEM-004T ") +
        (pzemHealthValid() ? "OK" : "NO")
      );

      lcdLine(
        2,
        "V:" +
        valueOrDash(pzem.voltageV, 1, pzem.hasValue) +
        " I:" +
        valueOrDash(pzem.currentA, 3, pzem.hasValue)
      );

      lcdLine(
        3,
        "P:" +
        valueOrDash(pzem.powerW, 1, pzem.hasValue) +
        " PF:" +
        valueOrDash(pzem.powerFactor, 2, pzem.hasValue)
      );
      break;

    case 3:
      lcdLine(
        1,
        "TANAH 1 " +
        soilStateText(soil1)
      );

      if (soil1.complete) {
        lcdLine(
          2,
          "M:" +
          String(soil1.raw[0] / 10.0f, 1) +
          "% T:" +
          String(((int16_t)soil1.raw[1]) / 10.0f, 1)
        );
        lcdLine(
          3,
          "pH:" +
          String(soil1.raw[3] / 10.0f, 1) +
          " EC:" +
          String(soil1.raw[2])
        );
      } else {
        lcdLine(
          2,
          "Register:" +
          String(countSoilHave(soil1)) +
          "/7"
        );
        lcdLine(3, "Menunggu data...");
      }
      break;

    case 4:
      lcdLine(
        1,
        "TANAH 2 " +
        soilStateText(soil2)
      );

      if (soil2.complete) {
        lcdLine(
          2,
          "M:" +
          String(soil2.raw[0] / 10.0f, 1) +
          "% T:" +
          String(((int16_t)soil2.raw[1]) / 10.0f, 1)
        );
        lcdLine(
          3,
          "pH:" +
          String(soil2.raw[3] / 10.0f, 1) +
          " EC:" +
          String(soil2.raw[2])
        );
      } else {
        lcdLine(
          2,
          "Register:" +
          String(countSoilHave(soil2)) +
          "/7"
        );
        lcdLine(3, "Menunggu data...");
      }
      break;

    case 5:
      lcdLine(1, "TANDON");
      lcdLine(
        2,
        "Air:" +
        distanceText(
          slaveData.waterDistanceValid,
          slaveData.waterDistanceCm
        )
      );
      lcdLine(
        3,
        "Nutr:" +
        distanceText(
          slaveData.fertDistanceValid,
          slaveData.fertDistanceCm
        )
      );
      break;

    default:
      lcdLine(1, "FLOW & OUTPUT");
      lcdLine(
        2,
        "A:" +
        valueOrDash(
          slaveData.waterFlowLpm,
          2,
          slaveData.hasValue
        ) +
        " N:" +
        valueOrDash(
          slaveData.fertFlowLpm,
          2,
          slaveData.hasValue
        )
      );
      lcdLine(
        3,
        String("CH3:") +
        (
          (relayState & (1U << (PUMP_WATER_RELAY - 1)))
          ? "ON"
          : "OFF"
        ) +
        " CH1:" +
        (
          (relayState & (1U << (PUMP_FERTILIZER_RELAY - 1)))
          ? "ON"
          : "OFF"
        )
      );
      break;
  }
}

void renderSensorStatus() {
  uint8_t page =
    (uint8_t)(
      (millis() / 3000UL) %
      3UL
    );

  lcdLine(
    0,
    "STATUS SENSOR"
  );

  if (page == 0) {
    lcdLine(
      1,
      "Nutri:" +
      String(nutriStateText()) +
      " Air:" +
      String(shtStateText())
    );

    lcdLine(
      2,
      "Soil1:" +
      soilStateText(soil1)
    );

    lcdLine(
      3,
      "Soil2:" +
      soilStateText(soil2)
    );
  } else if (page == 1) {
    lcdLine(
      1,
      String("PZEM:") +
      (pzemHealthValid() ? "OK" : "NO")
    );

    lcdLine(
      2,
      "Slave:" +
      String(slaveStateText()) +
      " RTC:" +
      String(rtcReady ? "OK" : "NO")
    );

    if (pzem.hasValue) {
      lcdLine(
        3,
        "PZEM Addr:0x" +
        String(
          pzem.respondingAddress,
          HEX
        )
      );
    } else {
      lcdLine(
        3,
        "PZEM menunggu data"
      );
    }
  } else {
    lcdLine(
      1,
      String("ETH:") +
      (SPFF_ENABLE_ETHERNET_RUNTIME ? (ethernetUsable() ? "OK" : "NO") : "OFF") +
      " WiFi:" +
      (WiFi.status() == WL_CONNECTED ? "OK" : "NO")
    );

    lcdLine(
      2,
      String("NTP:") +
      (SPFF_ENABLE_NTP_RUNTIME ? (ntpEverSynced ? "SYNC" : "WAIT") : "OFF")
    );

    lcdLine(
      3,
      String("PZEM:") +
      (pzemHealthValid() ? "OK" : "NO")
    );
  }
}


void renderCalibrationMenu() {
  renderMenu(
    CALIB_ITEMS,
    CALIB_COUNT,
    calibIndex
  );
}

void renderCalibrationInfo() {
  lcdLine(
    0,
    "KALIBRASI SENSOR"
  );

  switch (calibIndex) {
    case 0:
      lcdLine(1, "Nutrisi pH/EC/T");
      lcdLine(
        2,
        "pH:" +
        valueOrDash(nutri.ph, 2, nutri.hasValue) +
        " EC:" +
        valueOrDash(nutri.ec, 0, nutri.hasValue)
      );
      break;

    case 1:
      lcdLine(1, "Udara T/RH");
      lcdLine(
        2,
        "T:" +
        valueOrDash(sht.temp, 1, sht.hasValue) +
        " RH:" +
        valueOrDash(sht.rh, 1, sht.hasValue)
      );
      break;

    case 2:
      lcdLine(1, "Tanah 1");
      lcdLine(
        2,
        "Valid:" +
        String(countSoilHave(soil1)) +
        "/7"
      );
      break;

    case 3:
      lcdLine(1, "Tanah 2");
      lcdLine(
        2,
        "Valid:" +
        String(countSoilHave(soil2)) +
        "/7"
      );
      break;

    case 4:
      lcdLine(1, "Level Tandon");
      lcdLine(
        2,
        distanceText(
          slaveData.waterDistanceValid,
          slaveData.waterDistanceCm
        ) +
        "/" +
        distanceText(
          slaveData.fertDistanceValid,
          slaveData.fertDistanceCm
        )
      );
      break;

    default:
      lcdLine(1, "Flow Air/Nutrisi");
      lcdLine(
        2,
        valueOrDash(
          slaveData.waterFlowLpm,
          2,
          slaveData.hasValue
        ) +
        "/" +
        valueOrDash(
          slaveData.fertFlowLpm,
          2,
          slaveData.hasValue
        )
      );
      break;
  }

  lcdLine(
    3,
    "Web: /calibration"
  );
}

void renderWifiOta() {
  bool page =
    ((millis() / 3000UL) % 2UL) == 0UL;

  if (page) {
    lcdLine(
      0,
      "WIFI ROUTER"
    );

    lcdLine(
      1,
      fieldWifiSsid.length()
      ? fieldWifiSsid
      : "Belum diatur"
    );

    lcdLine(
      2,
      String("Status:") +
      (
        WiFi.status() == WL_CONNECTED
        ? "CONNECTED"
        : "OFFLINE"
      )
    );

    lcdLine(
      3,
      WiFi.status() == WL_CONNECTED
      ? WiFi.localIP().toString()
      : "AP 192.168.4.1"
    );
  } else {
    lcdLine(
      0,
      "OTA PROGRAM"
    );

    lcdLine(
      1,
      "Router:/update"
    );

    lcdLine(
      2,
      "AP:192.168.4.1"
    );

    lcdLine(
      3,
      "WiFi:/wifi"
    );
  }
}

void renderSoilDetail(
  uint8_t number,
  const SoilData &soil
) {
  lcdLine(
    0,
    "Sensor Tanah " +
    String(number) +
    " " +
    soilStateText(soil)
  );

  if (!soil.complete) {
    lcdLine(1, "Menunggu data valid");
    lcdLine(
      2,
      "Data valid " +
      String(
        countSoilHave(soil)
      ) +
      "/7"
    );
    lcdLine(3, "CANCEL untuk kembali");
    return;
  }

  bool page =
    ((millis() / 3000UL) % 2UL) == 0UL;

  if (page) {
    lcdLine(
      1,
      "Kelembapan:" +
      String(
        soil.raw[0] / 10.0f,
        1
      ) +
      "%"
    );

    lcdLine(
      2,
      "Suhu:" +
      String(
        ((int16_t)soil.raw[1]) /
        10.0f,
        1
      ) +
      "C"
    );

    lcdLine(
      3,
      "pH:" +
      String(
        soil.raw[3] / 10.0f,
        1
      ) +
      " EC:" +
      String(
        soil.raw[2]
      )
    );
  } else {
    lcdLine(
      1,
      "Nitrogen:" +
      String(
        soil.raw[4]
      )
    );

    lcdLine(
      2,
      "Fosfor:" +
      String(
        soil.raw[5]
      )
    );

    lcdLine(
      3,
      "Kalium:" +
      String(
        soil.raw[6]
      )
    );
  }
}
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
void loop() {
  appLoop();
}
