rizkyarfians/spff-iot-greenhouse/(commit log)

2026-08-21 fix: retain last known sensor values
2026-08-23 dashboard:update UI Dashboard Card Sensor
2026-08-23 mqtt:fix flow esp to server
2026-08-27 overall:fixing dashboard read sensor
2026-09-03 fix healthy sensor status
    [SPFF_MASTER_ESP32S3_OTA_1.3.2_SENSOR_HEALTH.ino]
2026-10-17 Calculate tank levels using water 180cm and fertilizer 90cm
2026-10-17 dashboard sensor fix
2026-10-17 feat: add dashboard pump status card
2026-10-17 feat: add dashboard pump status card2
2026-10-18 control page relayout
